Teslassian/E344/Reports/Assignment 1/App-B.tex

\chapter{GitHub Activity Heatmap}
\makeatletter\@mkboth{}{Appendix}\makeatother
\label{appen:github_heatmap}

     \begin{figure}[!htb]
     \centering
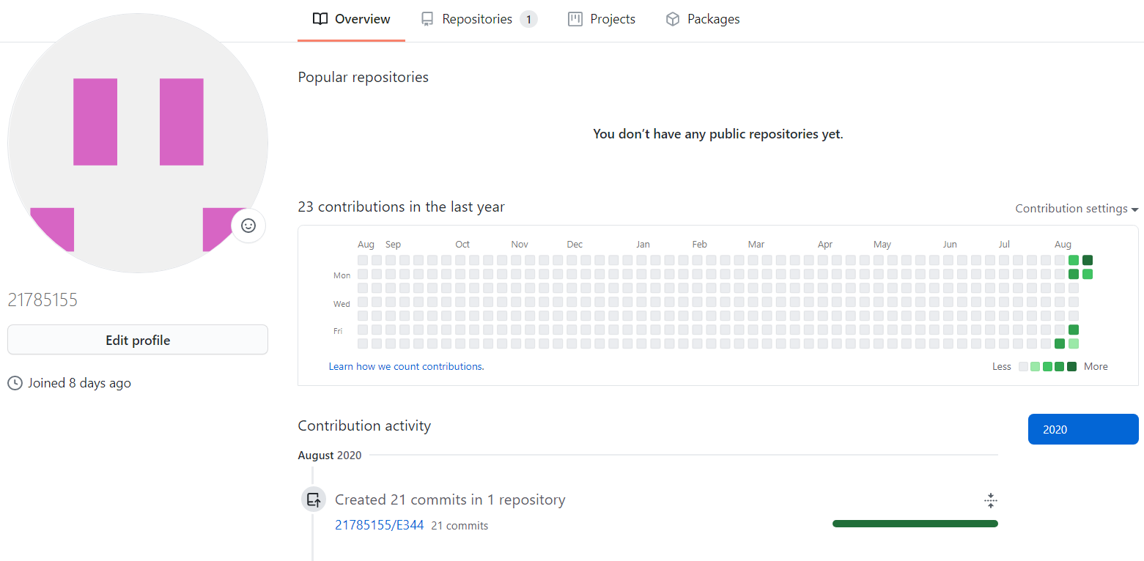
[picture p28: Reports/Assignment 1/Figures/heat.png]
     	\fbox{}
	\label{fig:github}
	\end{figure}
