Teslassian/E344/Reports/Assignment 3/von_Eschwege_21785155_A3.pdf

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

# E344 Assignment 3

## Daniel von Eschwege

21785155

Report submitted in partial fulfilment of the requirements of the module Design (E) 344 for the degree Baccalaureus in Engineering in the Department of Electrical

and Electronic Engineering at Stellenbosch University.

## October 25, 2020

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

## Plagiaatverklaring / Plagiarism Declaration

1. Plagiaat is die oorneem en gebruik van die idees, materiaal en ander intellektuele eiendom van ander persone asof dit jou eie werk is.
Plagiarism is the use of ideas, material and other intellectual property of another’s work and to present is as my own.
2. Ek erken dat die pleeg van plagiaat ’n strafbare oortreding is aangesien dit ’n vorm van diefstal is.
I agree that plagiarism is a punishable offence because it constitutes theft.
3. Ek verstaan ook dat direkte vertalings plagiaat is.
I also understand that direct translations are plagiarism.
4. Dienooreenkomstig is alle aanhalings en bydraes vanuit enige bron (ingesluit die internet) volledig verwys (erken). Ek erken dat die woordelikse aanhaal van teks sonder aanhalingstekens (selfs al word die bron volledig erken) plagiaat is.
Accordingly all quotations and contributions from any source whatsoever (including the internet) have been cited fully. I understand that the reproduction of text without quotation marks (even when the source is cited) is plagiarism
5. Ek verklaar dat die werk in hierdie skryfstuk vervat, behalwe waar anders aangedui, my eie oorspronklike werk is en dat ek dit nie vantevore in die geheel of gedeeltelik ingehandig het vir bepunting in hierdie module/werkstuk of ’n ander module/werkstuk nie.
I declare that the work contained in this assignment, except where otherwise stated, is my original work and that I have not previously (in its entirety or in part) submitted it for grading in this module/assignment or another module/assignment.
21785155 Studentenommer / Student number | Handtekening / Signature
D.H. von Eschwege Voorletters en van / Initials and surname | October 25, 2020 Datum / Date

i

# Contents

Declaration | i
List of Figures | iv
List of Tables | v
Nomenclature | vi
1. System design | 1
2. Voltage regulation | 3
3. Temperature sensor conditioning circuit | 6
4. Heart rate sensor | 10
5. Calibration and digitisation | 15

ii

6. System and conclusion | 17
Bibliography | 18
A. Social contract | 19
B. GitHub Activity Heatmap | 20
C. Stuff you want to include | 21

iii

# List of Figures

1.1. System Diagram | | 1
2.1. Linear Voltage Regulator | | 3
2.2. Switchmode Voltage Regulator | | 4
2.3. Switchmode Voltage Regulator Noise | | 4
2.4. Linear Voltage Regulator Output | | 5
2.5. Switchmode Voltage Regulator Output | | 5
3.1. Temperature Sensor Circuit | | 7
3.2. Simulated bode plot of filter | | 8
3.3. Complete Circuit Output | | 9
4.1. Complete Circuit | 10
4.2. Fast fourier transform of stimulus | 11
4.3. Frequency response of filters | 13
4.4. Filter input and output | 13
4.5. Signal Conditioning | 13
4.6. Full input versus output range | 13
4.8. Total current usage | 14
5.1. Voltage against temperature | 15
5.2. Flow chart for heart-rate digitisation | 16

iv

# List of Tables

2.1. Comparison of Voltage Regulators | | 4
3.1. Temperatures and Corresponding Voltage Levels | | 6

v

# Nomenclature

Variables and functions

fc | Cutoff frequency
VREF | Reference voltage
Av | Gain
β | Feedback fraction
VCM | Common-mode voltage
VID | Differential-mode voltage
η | Efficiency
ωn | Natural Frequency
tr | Rise time (90%)
Vref | Reference Voltage

vi

Acronyms and abbreviations

PWM | Pulse-width modulation
FFT | Fast Fourier transform
DC | Direct Current
Q-factor | Quality factor
BPM | Beats per minute
UTP | Upper trip point
LTP | Lower trip point
AC | Alternating Current
DC | Direct Current
ADC | Analog-to-Digital Converter

vii

# Chapter 1

# System design

## 1.1. System overview

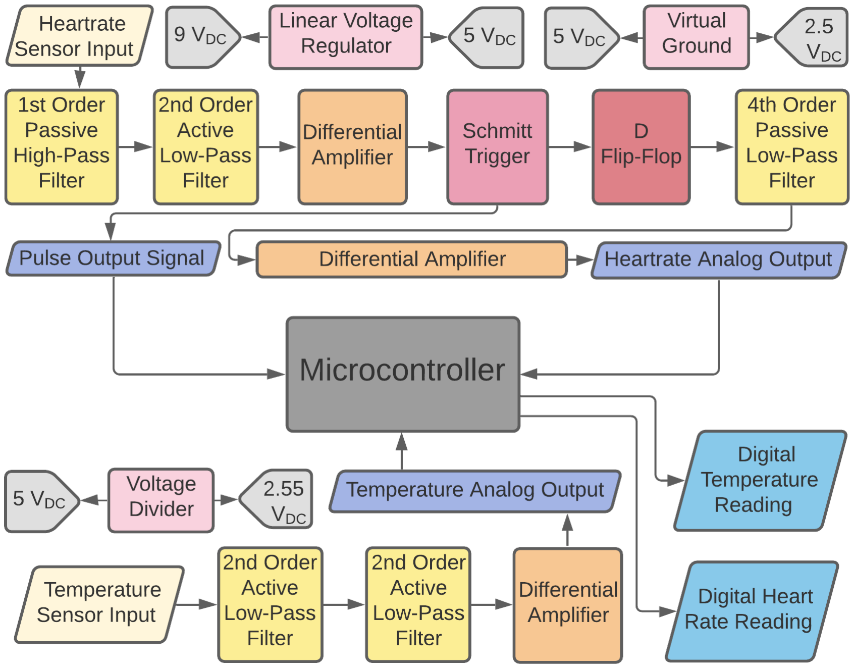
[picture p29: figure]

Figure 1.1: System Diagram

A health monitoring system is designed, consisting of a temperature sensor and an optic heart-rate monitor, interacting with a microcontroller. Figure 1.1 provides an overview. Since physical sensor measurements are ill-suited for digital interfacing, the main focus of this report is the conditioning, filtering and amplification of the aforementioned.

The temperature sensor input is subject to noise, has an unwanted DC offset and an amplitude of insufficient magnitude for AD-conversion. Two second-order low-pass filters were cascaded to clear the signal of noise. This may seem excessive at first, but the cascaded setup allows for the use of less costly components (see Section 3.2), as well as producing an output signal subject to very low noise (see Section 3.3), crucial with regards accuracy in Assignment

3. Following filtering, amplification is required. Since the filtered signal still contains a DC offset, and the differential amplifier requires a virtual ground, the voltage divider connects to the amplifier in such a way as to simultaneously remove the input DC offset and add the virtual ground. The signal is thus amplified to the degree required by a microcontroller ADC.

The heart-rate sensor input is to be converted to a pulse signal and an analogue output, corresponding to heart-beats and the heart-rate respectively. On account of the noise present in the sensor input, signal conditioning is required. Furthermore, the small amplitude of the sensor input necessitates amplification. A first order passive high-pass filter and a second order active low-pass filter attenuate both high- and low-frequency noise. Despite designing with maximal simplicity in mind to reduce cost and complexity, the filters still performing more than adequately. Thereafter, a differential amplifier produces a signal with a large amplitude and little noise. A Schmitt Trigger then outputs a pulse signal with a frequency corresponding to the heart-rate. The Schmitt Trigger was chosen as it provides a noise margin via hysteresis. An analogue voltage output is required for the microcontroller -filtering and peak detection using diodes was considered but discarded, as non-linear diodes result in extremely slow simulation. Rather, the pulse output signal was converted to a pulse-width modulated signal, where the frequency of the former determines the duty cycle of the latter. This was done as PWM signals lend themselves to conversion-to-analogue by simple filtering. The PWM signal was obtained by using a D Flip-Flop and a RC-circuit (see section 4.2). A fourth order passive RC filter is then used - passive components reduce cost,

current usage and simulation time. The filter is of high order as to minimize noise while meeting the settling time requirement. Finally, the signal is amplified to achieve the required range.

A microcontroller produces digital readings of the temperature and heart-rate by using the analogue output voltage (representative of the temperature measurement) and the pulse output signal (representing the the heart-rate) in a calibration formula programmed into the

microcontroller, where the former is linearly scaled and the latter is converted to a digital reading using the signal frequency. The frequency is detected by measuring the time-interval between rising edges.

A voltage regulator supplies power to all sub-circuits of which the system is comprised. Capable of a maximum current of 100 mA at 5 V, it is more than sufficient to supply the current drawn by Assignments 1, 2 and 3 - 12.8 mA, 13.0 mA and 50 mA respectively, where the current draw for Assignment 3 is estimated based on the typical current draw of a microcontroller of the type that would suffice for analogue-to-digital conversion of the heart-rate and temperature data [1]. All circuits were designed with conservative current use in mind as to increase

efficiency of the health-monitoring system.

# Chapter 2

# Voltage regulation

## 2.1. Introduction

Given a 9 VDC battery, a voltage regulator is required to reduce the voltage level to 5 VDC, as this is the level required by the operational amplifiers used in the rest of the circuit. Two voltage regulators were considered: the LM7805 linear regulator as well as the LM2595 switchmode regulator, which were both analysed with regards to efficiency and noise by means of calculations and simulations. According to the literature, the linear regulator produces insignificant levels of noise, but has low power efficiency of around 50% for input and output of 9 VDC and 5 VDC [2] respectively. The switchmode regulator can provide power efficiency of around 85%, but outputs a considerable amount of noise [3]. With the aforementioned in mind, both of the regulators were simulated (Section 2.2) to determine the best trade-off

between low noise and efficiency.

## 2.2. Design

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
LM7805

V1

9

9V | Regulated_Output

Figure 2.1: Linear Voltage Regulator

The LM7805 chip and its required peripheral circuit is shown in Figure 2.1. Component values were obtained from the datasheet [2]. For testing purposes, a 50 Ω

load was connected to the regulator, drawing 100 mA.

The LM2595 chip is shown in figure 2.2, built into the required peripheral circuit. Capacitor and inductor values were obtained from the datasheet [3]. Resistor values were calculated:

VOUT = VREF

1 +

R2
R1

!
where VREF = 1.23V

Selecting R1 as 1 kΩ, with Vout as 5 V gives R2 as 3065 Ω. For testing purposes, a 50 Ω load was connected to the regulator, drawing 100 mA.

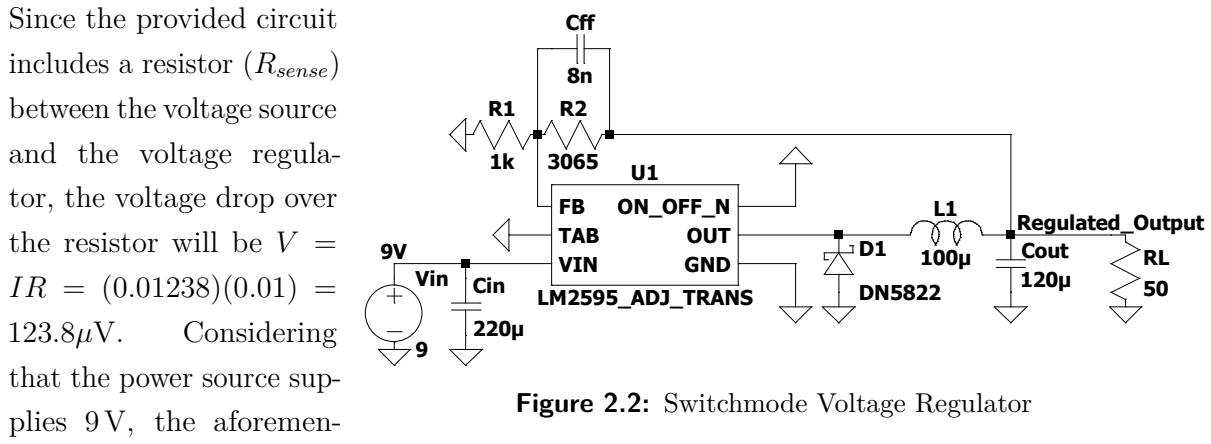
[picture p30: figure]
Cout; Cin; RL 50 Vin; Cff; FB TAB VIN; ON_OFF_N OUT GND; LM2595_ADJ_TRANS; Regulated_Output; Since the provided circuit; includes a resistor (Rsense); between the voltage source; and the voltage regula-; tor, the voltage drop over; the resistor will be V =; Considering; that the power source sup-; plies 9 V, the aforemen-

Figure 2.2: Switchmode Voltage Regulator

tioned voltage drop is negligible - it is not nearly enough to approach the dropout voltages of the voltage regulators, which are 6.7 V for the LM7805 and 5.8 V for the LM2595 in the case of a 5 V output.

## 2.3. Results

The input and output power measurements are displayed in table 2.1. Comparing the efficiency of the respective regulators, it is clear that the switchmode regulator is considerably more efficient. However, simulation results in a settling time of 1.24 ms, which is quite slow.

Table 2.1: Comparison of Voltage Regulators

| Iin [mA] | Iout [mA] | Pin [mW] | Pout [mW] | η [%]
LM7805 | 105.06 | 100.05 | 945.54 | 500.55 | 52.93
LM2595 | 57.54 | 99.65 | 517.86 | 496.6 | 95.89
Furthermore, | the
switchmode regulator
creates noise levels
of up to 950 µVpp in
the output, as can
be seen in figure 2.3,
whereas the linear regulator produces almost no noise (figure 2.4). Noise is a problem, as the

large gain of the differential amplifier will increase the noise levels, which will distort the output.


Figure 2.3: Switchmode Voltage Regulator Noise

The output graphs of the voltage regulators are shown in figures 2.4 and 2.5, and clearly demonstrate that both regulators produce the desired output current and voltage. The input current for the switchmode regulator is not shown as it obscures the graph, but it has an average value of 57.54 mA. All relevant values can be found in table 2.1.

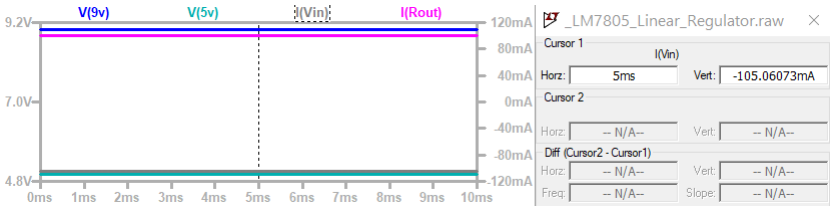
[picture p31: figure]

Figure 2.4: Linear Voltage Regulator Output

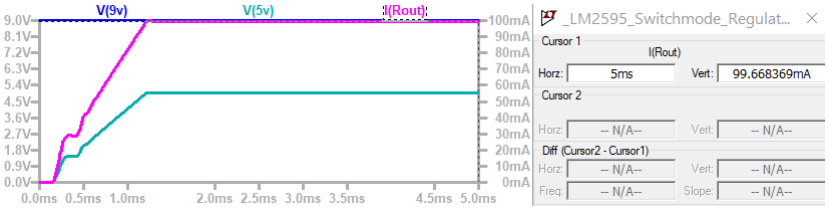
[picture p32: figure]

Figure 2.5: Switchmode Voltage Regulator Output

## 2.4. Summary

Concluding, it has been shown that both regulators behave as expected, but that the levels of noise present in the switchmode regulator make it unsuitable for the design at hand, as input signals, and thus the noise as well, will be amplified to levels of noise in the output signal that are unacceptable for an ADC input. The linear regulator will therefore be used. This choice was made despite the fact that the switchmode regulator is approximately 40% more

efficient than the linear regulator. However, since the total current drawn is still very low, efficiency is not of concern.

# Chapter 3

# Temperature sensor conditioning circuit

## 3.1. Intro

The temperature sensor signal presents as DC with 50 Hz AC noise superimposed. The sensor output amplitude is too small to act as ADC input and the desired range is only from 34◦C to 42◦C. The two aforementioned considerations necessitate amplification of the relevant part

of the temperature sensor signal to a 0 to 5 V range. Conditioning circuitry is thus required, namely a filter, an offset removing subcircuit, as well as an amplifier. The filter attenuates the AC noise, the offset subcircuit removes enough of the DC offset as to obtain an output signal centered around 2.5 V, ensuring the largest possible output swing. Finally, the amplifier increases the magnitude of the input signal in order to be suitable as input for an ADC.

## 3.2. Design

The amplifier was designed first, as its gain serves as the determining factor for the amount of noise reduction that is required from the filter. A TLC2272 op-amp was chosen as it allows for an output very close to its rails. Since the output signal has to be centered around 2.5 V, a differential amplifier was decided upon, allowing for adjustment of the negative input in order to determine the output offset. The zero-reference temperature sensor voltage (Vzero) is 440 mV, and increases by 35 mV for every 1◦C (V∆). Therefore Vtemp = Vzero + V∆ × T emp.

As shown in table 3.1, the maximum input voltage swing equals 1.91 − 1.63 = 0.28V, and

Table 3.1: Temperatures and Corresponding Voltage Levels

Temperature [◦C] | 32 | 38 | 42
Voltage [V] | 1.63 | 1.77 | 1.91

has a DC offset of 1.77 V. Amplification is needed to reach an output voltage swing of 5 V, which, combined with a 2.5 V
DC offset, ensures that the circuit uses the input range in accordance to specification, while excluding the lower and upper temperature ranges (i.e. below 34◦C and above 42◦C). Therefore:

Av =

Vout

Vin

=

5
0.28

= 17.86

Considering the current design requirement of 25 mA maximum, Rinput is selected as 10 kΩ, which will therefore, at the highest possible voltage level of 5 V, draw 0.5 mA. This gives Rfeedback = 178.6kΩ, according to Av =

Rfeedback
R

[4]. Rinput corresponds to R1 and R2, and

Rfeedback to R3 and R4 in the design diagram (figure 3.1), which is shown here already as to

aid with explanation of the design process. Rfeedback required adjustment to 230 kΩ upon simulation due to the non-linear Av curve characteristic of op-amps. However, Av = 17.86 is still used in calculations as that is the gain obtained after adjustment of Rfeedback.

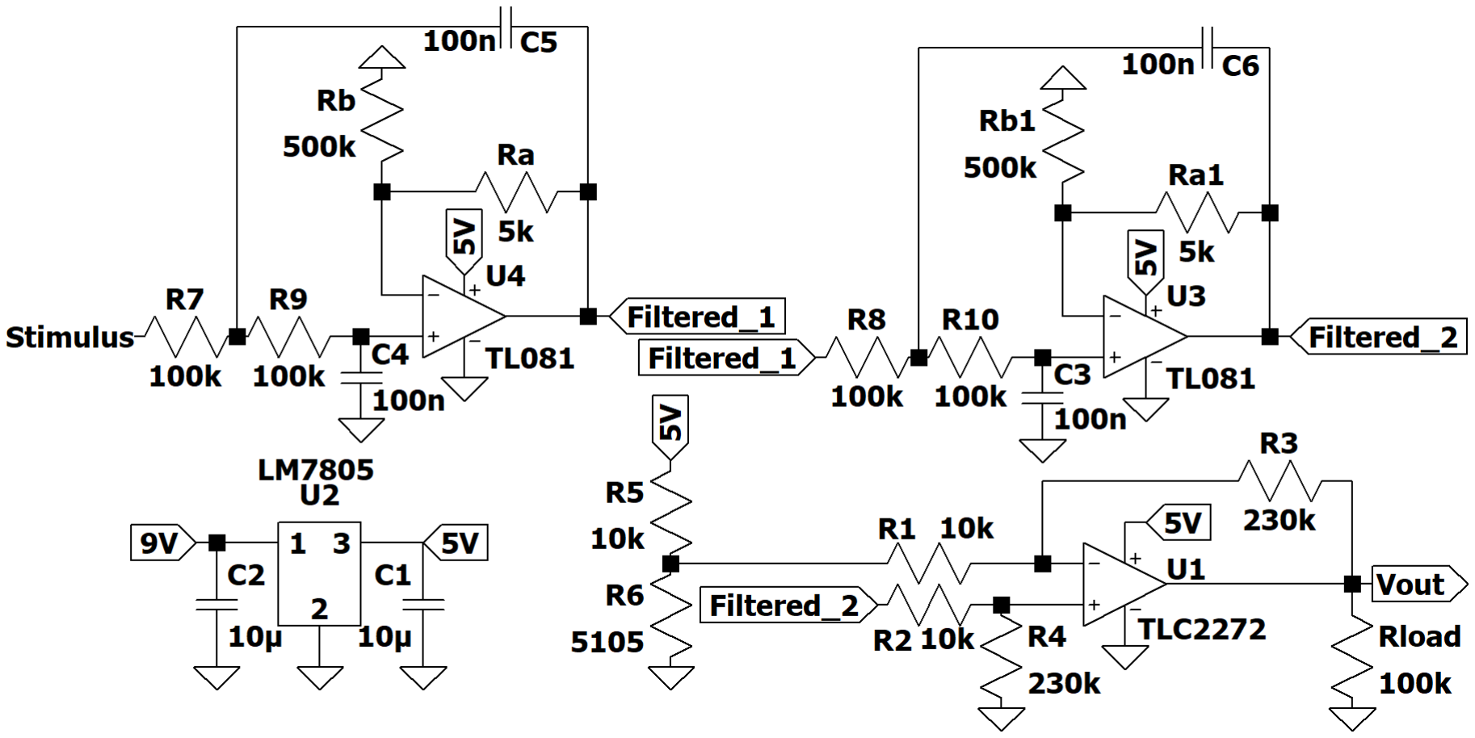
[picture p33: figure]

Figure 3.1: Temperature Sensor Circuit

Two points require consideration:

1. The DC offset of the input signal is undesired and has to be removed as to obtain a zero-mean input signal. This can be achieved by designing another sub-circuit using another op-amp, for example. This adds to the cost and complexity of the circuit.
2. The output signal has to be centered around 2.5 V. This means that a DC offset has to be added in the form of a virtual ground.

When considered in conjunction with each other, the DC offset alteration can be resolved in one step, thereby reducing cost and complexity significantly. The decision was therefore made to use a differential amplifier with the input signal connected to the positive input, after which the voltage required at the negative input can be calculated in such a way as to simultaneously subtract the offset and add the virtual ground in one step, thereby producing an output DC offset of 2.5 V. This approach also simplifies the design procedure, as it renders a separate virtual ground completely superfluous, thereby also removing the need to perform any virtual ground calculations per se. (Lecture Video 2, minute 11 [5] mentions this to be an acceptable approach). For a non-inverting amplifier, the calculation thus reduces to a simple differential amplifier gain formula [4]:

Vout =

Rfeedback
R

(Vin+ − Vin−) → 2.5 = 17.86 (1.77 − Vin−)

With Vout as 2.5 V, Vin+ as 1.77 V and the resistor values as calculated previously, Vin− = 1.63 V. The voltage at Vin− can be set by means of a voltage divider circuit, which takes 5 V as input and is calculated as follows (resistor names in formulae are selected to conform with Figure 3.1): Vin− = 5( R6
R6×R5

). Selecting R5 as 10 kΩ gives R6 = 4.84 kΩ.

Here, the common-mode voltage, VIC, needs consideration; the TLC2272 can operate with a common-mode voltage of VDD− to VDD+ − 1.5 [6]. Since Vin+max
is 1.91 V and Vin− is 1.63 V, the largest possible common mode voltage is VIC =

1.91+1.63
2 = 1.77 V, which is well below the maximum limit. Since Vin− stays constant, the lower limit will never be reached either.

Simulation was used to select a filter, and has shown the following: a passive low-pass filter is very simple, but produces too much noise and does not meet the settling time requirement. The active low-pass filter meets both the noise and settling time requirements, but requires the TLC2272 op-amp to do so. Since a single TLC2272 op-amp is more expensive than multiple TL081 op-amps, the decision was made to rather use cascaded second order low-pass filters, using the TL081. This is somewhat more complex, but lowers the cost, as the final circuit now only uses three op-amps, two of which are the cheaper TL081 models. Assignment 3 further motivates the decision for increased filter complexity, as the cascaded setup produces an output signal with extremely low noise, which is indispensable for meeting the bonus requirements during calibration and digitisation - see section 5.1.2. Following selection, the filter is designed:

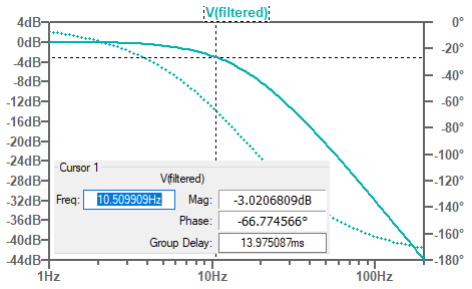
[picture p34: figure]

Figure 3.2: Simulated bode plot of filter

A filter gain of close to unity is desired; for RA =
500 kΩ, RA = 5 kΩ, according to the formula:
Av = 1 + RA
RB

[7]. The settling time requirement of

100 ms means that a cutoff frequency of more than 10 Hz is needed, while the attenuation of noise requires a cutoff frequency below 50 Hz. fc = 15 Hz was chosen - the bandwidth thus also is 15 Hz. Choosing R (R7 and R9 in the diagram) as 100 kΩ gives C (C4 and C5) as 106.1 nF, according

to fc =

1
2πRC . The given cutoff frequency implies a rise time of 19.1 ms according to tr ≈

1.8
wn

=

1.8
2π(15) [8]. This meets the requirement of 100 ms, even when cascaded. After design

completion, this filter is then duplicated and connected back-to-back in order to form cascaded second-order low-pass filters, as seen in figure 3.1. The simulated frequency response is shown in figure 3.2. While 10.5 Hz is somewhat lower than designed, it still falls within the range determined by the cutoff frequency and settling time requirements, as discussed previously. Assuming that each resistor is subjected to an average voltage of 2.5 V, while op-amps draws 3 mA [6], the calculated current consumption of the temperature sensor circuit is:

Itotal = (3) ².5

10k + (2) 2.5

230k + (4) 2.5

100k + (2) 2.5

500k + (3) ².5

5k + (2) 2.5
230k + (3)3mA = 11.38mA
This leaves 88.62 mA for the rest of the health-monitoring system.

## 3.3. Results

The designed circuit receives an input signal ranging from 1.67 to 1.94 V for Vin+, which is somewhat higher than the calculated values of 1.63 to 1.91 V, and is due to the filter adding some offset. This can easily be overcome by adjusting the voltage divider. Vin− receives 1.7 V. Both Vin− and Vin+ thus fall well within the allowable range for the TLC2272, which is from VDD− − 0.3 to VDD+ [6]. The circuit produces a signal centered at 2.5 V with an output swing of 4.86 V (figure 3.3a), exceeding the required 3.5 V. The absolute maximum amount of noise measured is 25.6 mV (figure 3.3c), and the settling time is 67 ms (figure 3.3d), thereby meeting the requirements of 50 mV and 100 ms respectively. Total current draw is 12.83 mA (figure 3.3b), well below the required 15 mA, and very close to the calculated 11.38 mA. The output signal (light blue) is shown in figure 3.3a.

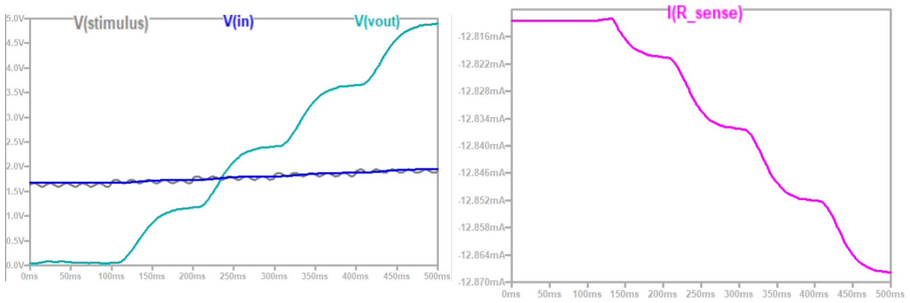
[picture p35: figure]

(a) Full Input and Output Range | (b) Current of Entire System

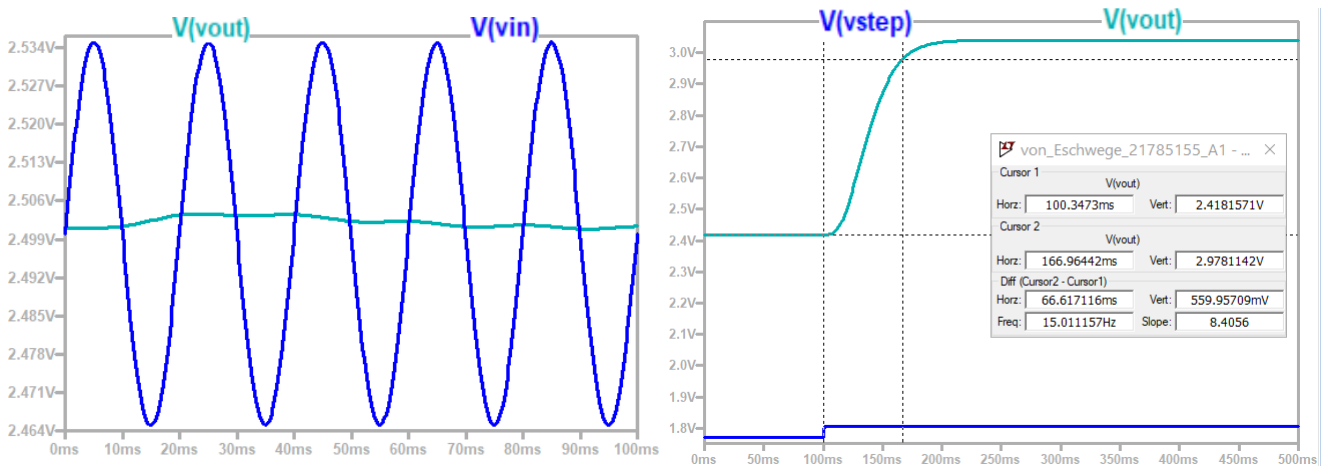
[picture p36: figure]

(c) Simulated Noise Suppresion | (d) Simulated Output Rise Time

Figure 3.3: Complete Circuit Output (a) Output Range: 0.1 to 4.85V. Input Range: 1.63 to 1.94 V. (b) Current draw below requirement. (c) Noise suppressed to negligible levels. (d) Settling time within 100 ms.

## 3.4. Summary

Concluding, the circuit performs very well and successfully amplifies the temperature sensor output to a level that is readable by the microcontroller ADC, all the while attenuating almost all noise present in the input. The design is somewhat more complex, which however is justified by the requirements of Assignment 3. While being complex, it still is inexpensive, as it uses less of the TLC2272 op-amps. The design meets all base and bonus requirements requirements with a good margin to spare, all the while using only three op-amps, two of which are the cheaper TL081 models.

# Chapter 4

# Heart rate sensor

## 4.1. Introduction

Circuits pertaining to signal conditioning, pulse signal and analogue output generation will be discussed. Conditioning is done via filtering and amplification, thereafter thresholding and pulse-width modulation is used to generate outputs. Active filters provide high input and low output impedance, and a large Q-factor [9]. A differential amplifier is suitable for amplification, as the gain is referenced against a customizable voltage [4]. A Schmitt Trigger is well-suited for pulse generation, as it provides a noise margin [10]. PWM signals can be converted to analogue using filtering [11].

## 4.2. Design

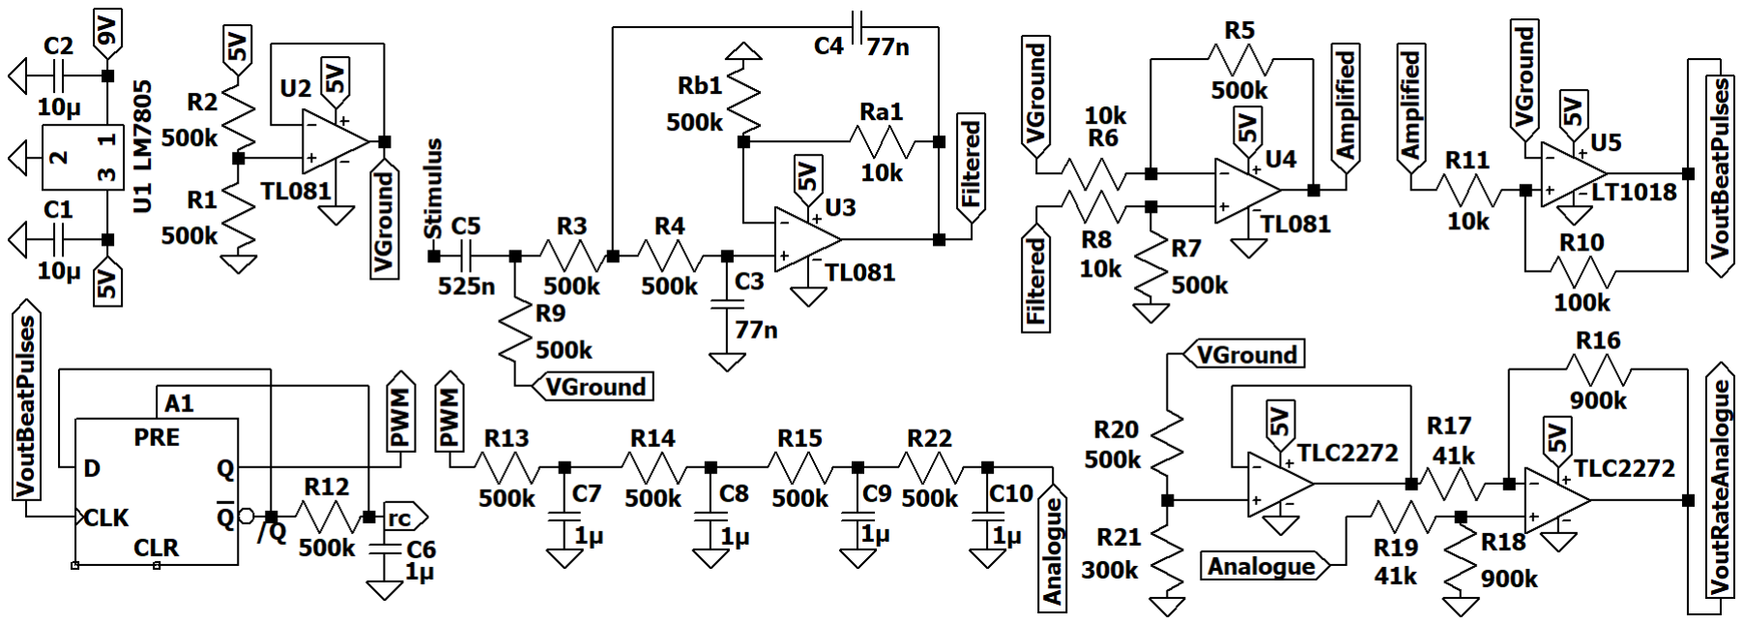
[picture p37: figure]

Figure 4.1: Complete Circuit

### 4.2.1. Signal Conditioning

The complete circuit is shown upfront in figure 4.1 to aid explanation. The largest resistor in sub-circuits is always chosen to be 500 kΩ as to reduce current usage. The TLC2272
op-amp has VCM of −0.3 to 4 V, VID = ±16 V , Vinmax | = VDD+ and Vinmin | = VDD− −
0.3 [6]. The TL081 has VCM of 1 to 4 V, VID = ±30 V , Vinmax | = 3.5 V and Vinmin | =
1.5 V [12]. This information is given here as to avoid repetition - refer here when op-amp

characteristics are discussed. The design process now follows. The FFT of the stimulus input in figure 4.2 shows information residing between 0.8 to 2.5 Hz, corresponding to 50 and 150 BPM respectively. The other peaks represent noise at 0.25 Hz, as well as at twice and three times the message signal, and higher. Noise distorts square wave output, necessitating filtering. A first order passive high-pass filter, fc = 0.606 Hz, attenuates the low-frequency noise at 0.25 Hz. R18 = 500 kΩ, thus C8 = 525 nF according to fc =

1
2πRC .


Figure 4.2: Fast fourier transform of stimulus

A virtual ground centres the signal around 2.5 V, ensuring that the LPF input falls within the common-mode range of the TL081, which is used as it inexpensive [13]. A second

order active low-pass filter, fc = 4.1 Hz, filters out high frequency noise. R5 = R6 = 500 kΩ, C1 = C2 = 77 nF - see aforementioned formula. Cutoff frequencies were selected to
remove noise maximally while minimally affecting heart-rate data. The signal should reside slightly above 2.5 V to facilitate amplification (to be discussed) and to ensure common-mode input range compliance in the next stage. Thus, Rb1 = 500 kΩ and Ra1 = 10 kΩ since Av = 1 + RA
RB

[7]. A filter output with DC offset slightly

above 2.5 V allows for the use of a differential amplifier with the existing virtual ground connected to the negative input, removing the need for additional circuitry otherwise required. The signal is amplified according to VOUT =

Ra
Rb

(V2 − V1) [4], where Ra corresponds to R7 and

R9 and Rb to R8 and R10. The gain of 50 was selected to again provide a DC offset of 2.5 V, as it facilitates implementation of the comparator (to be discussed). Since the amplified signal

has an amplitude of only 1.66 V, the inexpensive TL081 was chosen despite having a smaller output range. Next, the signal is fed into a Schmitt Trigger - the LT1018 comparator allows for output very close to 0 and 5V and has a high gain. 5 V is produced if the input exceeds the upper trip point (UTP) and 0 V if the input falls below the lower trip point (LTP) [10]. The hysteresis width (wh = UTP - LTP) serves as a noise margin around the reference voltage, VREF [10]. The DC offset of 2.5 V of the amplified signal requires VREF = 2.5 V, once again

allowing for the use of the existing virtual ground. Pulse duration is designed for the highest frequency, as it will then also meet the requirement for lower frequencies. Since 150 BPM corresponds to a period of 0.4 s, wh is selected to ensure an output pulse width of at least 150 ms; 200 ms selected to account for noise. The amplified signal approximates a sinusoid:
y1 = 1.66 sin(2π(2.5)t1) + 2.5 | (4.1) | y2 = 1.66 sin(2π(2.5)t2) + 2.5 | (4.2)

Subtracting 4.2 from 4.1 yields y1 − y2 = wh = 0.52 V for t1 =0.01 s and t2 = 0.21 s, resulting

in a theoretical pulse width ranging from 0.2 to 0.625 ms, which is sufficient. wh also is an order of magnitude larger than the highest input signal noise levels, increasing design fidelity. Now, UTP = 2.75 V, LTP = 2.25 V, UTP = VREF + βV cc and LTP = VREF − βV cc, thus β = 0.05 [10]. Further, β =

R22
R22+R21

. Thus R21 = 190 kΩ and R22 = 10 kΩ. (R21 was adjusted to 100 kΩ to account for loading effects). A one-shot was considered to extend the pulses, but

was omitted as it was superfluous. The pulse output frequency thus represents the heart-rate.

### 4.2.2. Analogue Transducer

Obtaining an output suitable for a microcontroller presents itself as a problem of converting frequency to analogue. The decision was made to obtain a PWM signal from the FM pulse signal, as PWM signals readily lend themselves to conversion-to-analogue using a simple low-pass RC filter. Pulse-width modulation was achieved by means of a D flip-flop. The essence of the design is to continually keep the output high at first, but to then drive the output low for a fixed time, once per period. Since the period of the clock signal varies against BPM, driving low for a fixed amount of time results in a different ratio of the pulse being low at different frequencies, producing a varying duty cycle. Specifically, the previously generated pulse signal is used as a clock signal for the D flip-flop, and the not-Q output is fed back into the data line. This would normally drive the output high for all time t; thus a RC circuit is added of which the capacitor is charged by the not-Q output, and connected to the SET-line of the flip-flop. Once the capacitor charges to 2.5 V, Q is pulled high and not-Q low until the next rising edge of the clock input inverts Q and not-Q. The result is a slightly delayed PWM signal, with a large duty cycle at high frequencies, and vice-versa. The PWM output is consistent as long as the capacitor charge time is selected to be shorter than the narrowest pulse of the clock signal. See section 4.3, figure 4.7a for output. For the RC circuit, R1 = 500 kΩ gives C = 1µ, according to the capacitor charge/discharge exponential equations - the extended solution (via Matlab scripting) is given in Appendix C

for the sake of brevity. Having obtained a PWM signal, a fourth order passive low-pass filter produces analogue values in the range of 0.95 to 1.2 V. A cutoff frequency of 0.3 Hz ensures maximal attenuation of noise while maintaining a 5% settling time of 10 seconds. Therefore

R = 500 kΩ and C = 1 µ. Finally, the analogue output is amplified by means of a TLC2272 differential amplifier with a negative input at 0.938 V. A gain of 20 produces a sufficient output range. Resistor values were increased as to minimize loading effects - thus R2 = R12 = 900 kΩ and R11 = R13 = 45 kΩ according to VOUT =

Ra
Rb

(V2 − V1) [4]. Loading effects still had a slight effect, and required adapting R11 and R13 to 41 kΩ. An analogue transducer is thus designed. For microcontroller integration, a log-linear scale can linearise the analogue output, and the calibration constant is calculated. The slope is 0.8−2.5
4.7−0.5 = −0.404. Thus, for 150 BPM, f = 2.5 = −0.404V + C = −0.404(0.5) + C → C = 2.702.

Total current is calculated using 1.4 mA per TL081 [12], 2.2 mA per TLC2272 [6] and 110 µA per LT1018 [14]. Non-trivial resistors are all approximated using 5 V over, as to err on the side of caution: 4(1.4m) + (2.2m) + (110n) + 16
5
500k

+ 3
| 5 10k

| + 2
| 5 41k
| +
5
100k
= 9.75 mA.

## 4.3. Results

The frequency response of the high- and low-pass filters gives −3dB at 0.61 Hz and −6dB at

4.3 Hz respectively - see figures 4.3a and 4.3b. This reflects design calculations near perfectly. Comparison of filter input and output in figure 4.4 shows a drastic noise reduction.

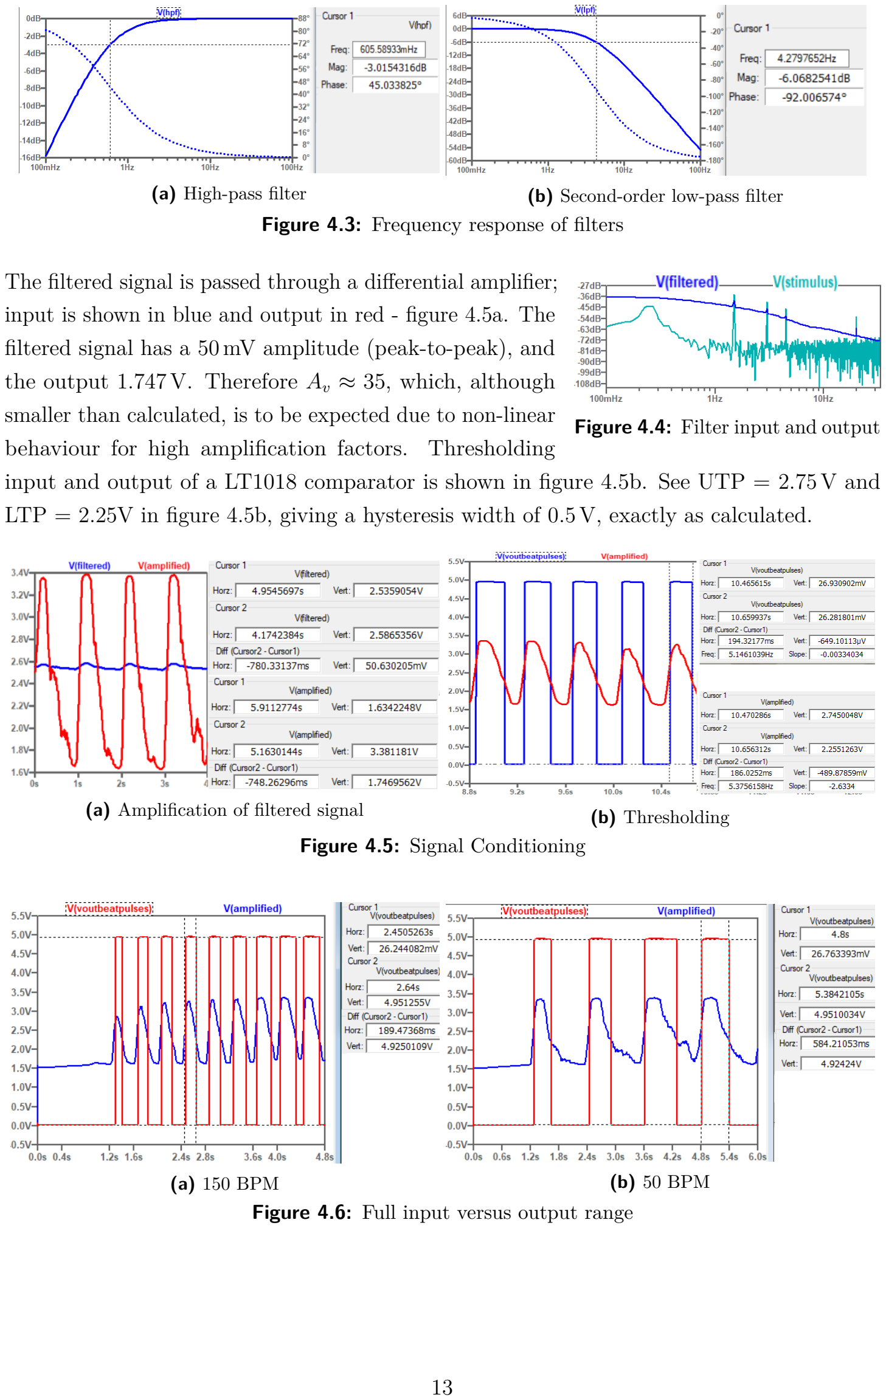
[picture p38: page 21]

(a) High-pass filter | (b) Second-order low-pass filter

Figure 4.3: Frequency response of filters

Figure 4.4: Filter input and output

The filtered signal is passed through a differential amplifier; input is shown in blue and output in red - figure 4.5a. The filtered signal has a 50 mV amplitude (peak-to-peak), and the output 1.747 V. Therefore Av ≈ 35, which, although

smaller than calculated, is to be expected due to non-linear
behaviour for high amplification factors. Thresholding
input and output of a LT1018 comparator is shown in figure 4.5b. See UTP = 2.75 V and LTP = 2.25V in figure 4.5b, giving a hysteresis width of 0.5 V, exactly as calculated.
(a) Amplification of filtered signal | (b) Thresholding

Figure 4.5: Signal Conditioning

(a) 150 BPM | (b) 50 BPM
Figure 4.6: Full input versus output range

The output ranges from 0.026 to 4.95V, with a pulse duration in range 189 to 584 ms in figures 4.6a and 4.6b, meeting the 150 ms requirement. The design remains consistent for specification deviations of ±10% amplitude and a DC offset variation of ± 0.2 V, as the

high-pass filter removes the DC component and the filter has a cutoff frequency low enough to greatly attenuate noise.

For the analogue transducer, a PWM signal is obtained. Section 4.2 explains the interrelation, where voutbeatpulses, pwm and rc in figure 4.7a correspond to the clock signal, Q, and the charging capacitor voltage respectively. The 5% settling time is 9.45 s. The duty cycle is 73% at 60 BPM and decreases to 56% at 150 BPM. Finally, amplification and filtering of the PWM signal produces analogue output, range 4.2 V (4.7b).

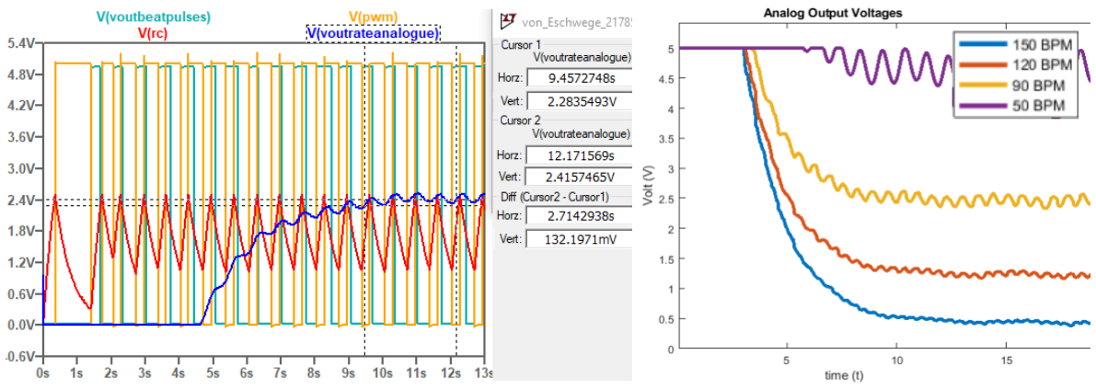
[picture p39: figure]

(a) PWM and settling time | (b) Analogue voltage output

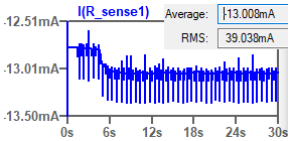
[picture p40: figure]

Figure 4.8: Total current usage

Total current draw is measured through Rsense, averaging 13.0 mA, meeting the bonus requirement of 15 mA - see figure 4.8. Considered in conjunction with Assignment 1, the combined current of 25.8 mA still is far less than the maximum current rating of 100 mA for the voltage regulator
- see section 2.2.

## 4.4. Summary

The design performs as expected, meeting all the requirements. Output pulse width is broader than required, analogue output is generated with discrete, non-overlapping values exceeding the required range, while settling to a final value according to specification. Current draw remains sub-15 mA. Upon implementation of the microcontroller, be cognizant of the fact that analogue output values scale in a slightly non-linear fashion. This is not a problem, and can easily be accounted for in software. By design, the system is limited to the 50 to 150 BPM range, but could be expanded using the existing design as a proof-of-concept.

# Chapter 5

# Calibration and digitisation

## 5.1. Temperature sensor

### 5.1.1. Analytical Design

Equation 5.1 for the sensor voltage and 5.2 for the amplifier, where the addition of a virtual ground and offset correction are combined by Vof fset.

Vsense = V0 + α(T) → T =

1
α
(Vsense − V0) | (5.1)

Vout = Av (Vsensor − Vof fset) → Vsensor =

Vout
Av
+ Vof fset | (5.2)

Combining 5.1 and 5.2 gives

T =

Vout
αAv

+

Vof fset − V0
α
= 1.6(Vout) + 34 | (5.3)

for V0 = 440 mV, α = 35 mV, Vof fset = 1.63 V, Av = 17.86. For an ADC:

ADC = (2¹⁰ − 1) Vin

Vref

→ Vin =

ADC(Vref )
2 10 − 1 | (5.4)

5.4 into 5.3, with Vout as ADC input, converts the sampled ADC value to temperature output:

T = (1.6)ADC(Vref )
2

10 − 1

+ 34 | (5.5)

### 5.1.2. Empirical Design

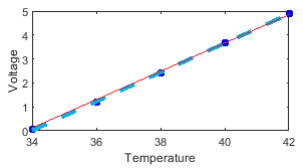
[picture p41: figure]

Figure 5.1: Voltage against temperature

Simulation yields the data points in figure
5.1. Linear regression results the empirical equation 5.6, graphed in light blue, which is implemented in software as to provide a digital temperature reading - see pseudocode below. Equation 5.5 corresponds closely to the analytical equation 5.3, graphed in red.

T = 1.644985924

Voutavg
+ 33.92887739 | (5.6)

Pseudocode:

V avg = V out / length(V out)
T = 1.644985924*V avg + 33.92887739

Python implementation yields a 1◦C temperature reading accuracy for the full input range,

which can, in part, be ascribed to the performance of the filters in section 3.2, which provide a signal almost completely devoid of noise. The accuracy requirement is met in less than 2 seconds, according to specification.

## 5.2. Heart rate sensor

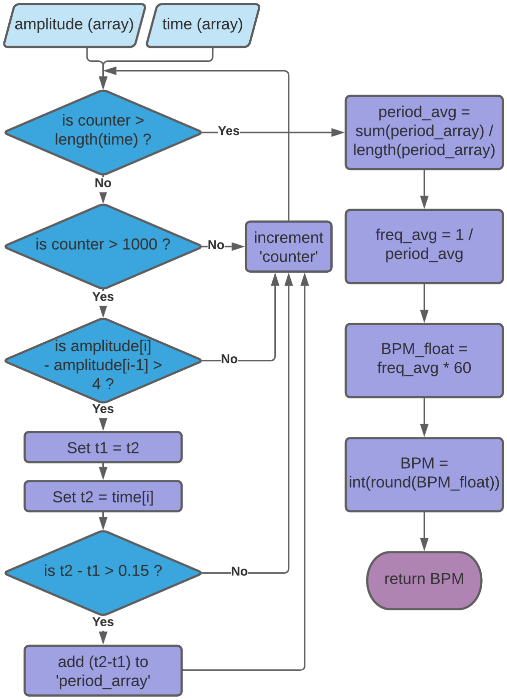
[picture p42: figure]

Figure 5.2: Flow chart for heart-rate digitisation

The heart-rate signal consists of square wave pulses of which the period correspond to the heart-rate (in BPM) ac-

cording to t =

60
BPM . For circuit output
data in the form of an signal amplitude and a time array, the approach is to set the difference between rising pulse edges as the period, averaged over 6 seconds of simulated time for increased accuracy. The frequency is then obtained from the period. Analytically, the frequency ranges from 0.83 to 2.5 Hz for heart-rates from 50 to 150 BPM. The heart-rate can thus be obtained by simply inverting the measured period and multiplying by 60: BPM =

60
t

. A flowchart of the algorithm is provided in figure 5.2. Empirical design was unnecessary as analytic design yielded accuracy up to 1 BPM upon implementation in Python. The accuracy requirement was met in less than 6 seconds, according to specification.

# Chapter 6

# System and conclusion

## 6.1. System

The complete design goes to show that a health-monitoring system, consisting of temperature and heart-rate sensing circuitry, powered by a voltage regulator and interfacing with a microcontroller, successfully performs its function while adhering to all base and bonus specifications. The modular design of different parts of the health-monitoring system simplifies both design and debugging.

The temperature sensor produces the desired output with full range. The filters ensure extremely low noise levels, allowing the ADC to distinguish the temperature to a very high degree of accuracy. The system uses more of the less costly components and is very power efficient.

The heart-rate sensor effectively converted a noisy input signal to a square wave output and an analogue output. Due to the second order low-pass filter, the heart-rate sensor is remarkably robust with respect to variations in noise, attenuating noise levels to below 6% of the signal

amplitude before creating a pulse output. The design also performs well on a variety of the normalised input data sets. Noise is filtered to the extent that it has a negligible effect on the digitalized reading. The system utilizes less costly components where possible and is very power efficient. Interfacing of real-world measurements with digital systems is achieved by connecting the heart-rate circuit to a microcontroller, producing a digital heart-rate reading.

## 6.2. Lessons learnt

1. LTSpice is a blessing, but can be an absolute nightmare with simulations. I’ve created a rough metric; it goes to show that 30% of my time was spent on circuit design, 10% on report writing, and 60% on debugging LTSpice simulation problems.
2. I believe to have greatly improved with regards to modularising and debugging not only circuits, but systems in general. Treating everything as a small problem to be solved furthered my conceptual understanding of component interaction.
3. I shouldn’t have gone surfing for the entirety of the first week of both terms. I lost a bunch of marks for saying this in Assignment 1, but the adage still holds true, so I’ll say it again.

# Bibliography

[1] “Arduino uno,” Farnell, 2018. [Online]. Available: https://www.farnell.com/datasheets/

1682209.pdf (https://www.farnell.com/datasheets/1682209.pdf)

[2] LM78LXXA 3-Terminal 0.1 A Positive Voltage Regulator, LM7805 Datasheet, Fairchild

Semiconductor Corporation, 2013.

[3] LM2595 SIMPLE SWITCHER® Power Converter 150-kHz 1-A Step-Down Voltage Regulator, LM2595 Datasheet, Texas Instruments, May 2016.
[4] W. Storr, “Operational amplifiers,” 2018. [Online]. Available: https://www.electronics-tutorials.ws/opamp
[5] M. J. Booysen, “E344 - lecture 2,” 2020. [Online]. Available: https://www.youtube.com/watch?v=5bzHyeFQCPo&feature=youtu.be (https://www.youtube.com/watch?v=5bzHyeFQCPo&feature=youtu.be)
[6] TLC227x: Advanced LinCMOS Rail-to-Rail Operational Amplifiers, TL2272 Datasheet,

Texas Instruments, 2016.

[7] W. Storr, “Filters,” 2018. [Online]. Available: https://www.electronics-tutorials.ws/filter
[8] H. Jordaan, “Control systems - 314,” 2020. [Online]. Available: https://learn.sun.ac.za/course/view.php?id=53481 (https://learn.sun.ac.za/course/view.php?id=53481)
[9] “Difference between active and passive filter.” [Online]. Available: https://circuitglobe.com/difference-between-active-and-passive-filter.html#ComparisonChart (https://circuitglobe.com/difference-between-active-and-passive-filter.html#ComparisonChart)
[10] W. Storr, | “Op-amp comparator,” | 2018. [Online]. Available: | https://www.
electronics-tutorials.ws/opamp/op-amp-comparator.html
[11] “Analog output - convert pwm to voltage.” [Online]. Available: https://www.instructables.com/id/Analog-Output-Convert-PWM-to-Voltage/ (https://www.instructables.com/id/Analog-Output-Convert-PWM-to-Voltage/)
[12] TL08xx: JFET-Input Operational Amplifiers, TL081 Datasheet, Texas Instruments, May

2015.

[13] “Octopart,” Octopart, 2020. [Online]. Available: https://octopart.com/
[14] LT1018 Micropower Dual Comparator, LT1018 Datasheet, Linear Technology.

# Appendix A

# Social contract

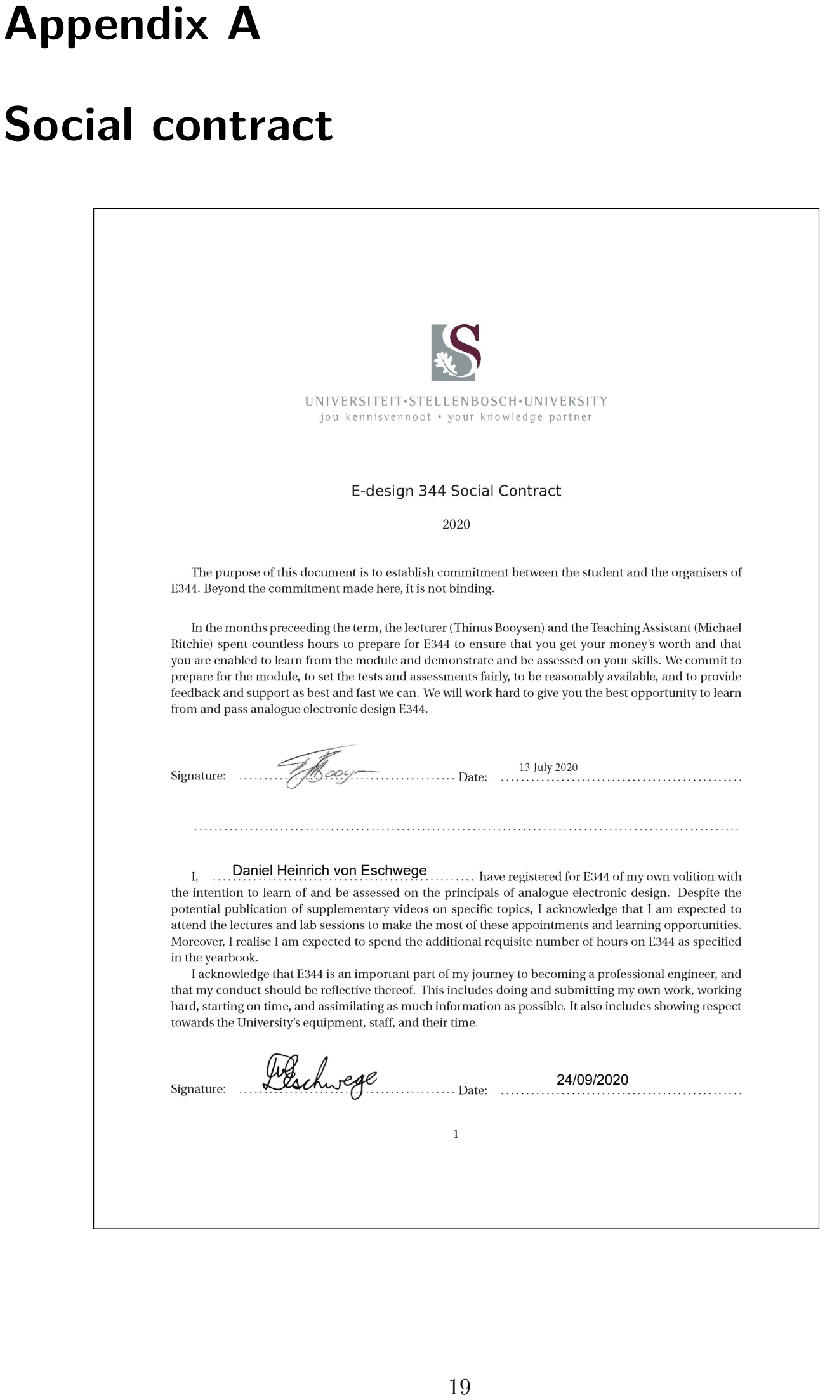
[picture p43: page 27]

24/09/2020

Daniel Heinrich von Eschwege

# Appendix B

# GitHub Activity Heatmap

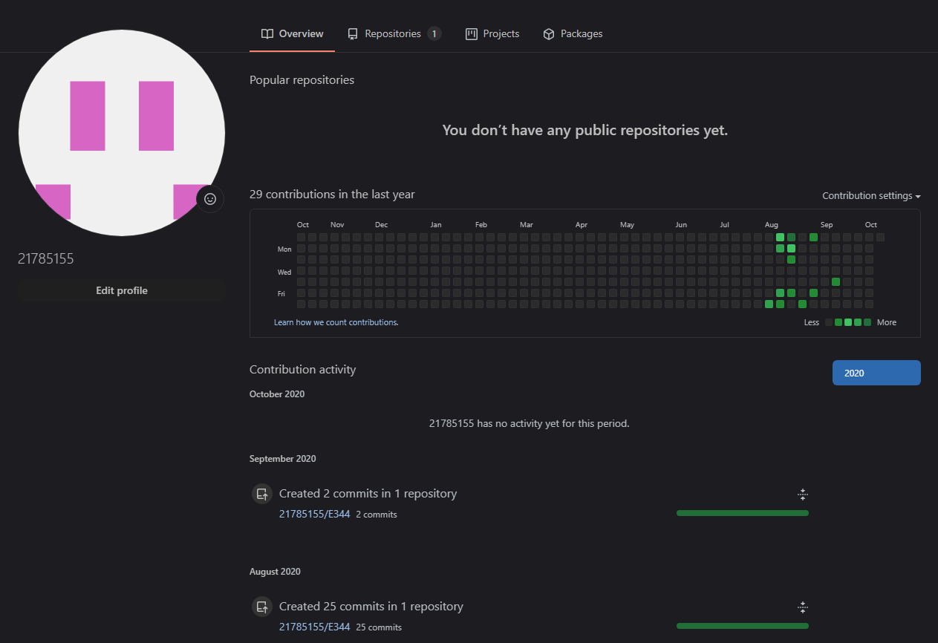
[picture p44: figure]

# Appendix C

# Stuff you want to include

### C.0.1. Calculation of transducer RC circuit

R1 = 500 kΩ. τ = RC. The capacitor charge oscillates between VL and VH. VH = 2.5 V. VL is reached for the first time at tL1 and VH at tH1
. VL is then reached at tL2

. For 150 BPM
(or 2.5 Hz), the pulse drives high for 0.2 ms. Since the capacitor has to charge faster than 0.2 ms, a charge time of 0.16 ms was selected to add a 20% margin, accounting for noise. Thus tH1 − tL1 = 0.16 and tL2 − tH1 = 0.4 − 0.16 = 0.24 for the 150 BPM signal. Finally,

VL = 5
1 − e

tL1
τ

VH = 5
1 − e

−tH1

τ

VL = VH

e

tL1
τ

giving C = 1µ, when solving using the following MatLab script:
