Teslassian/E344/Reports/Ass3Template/e344_A3_report.pdf

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

# E344 Assignment 3

## Egor Stewdent

00024601

Report submitted in partial fulfilment of the requirements of the module Design (E) 344 for the degree Baccalaureus in Engineering in the Department of Electrical

and Electronic Engineering at Stellenbosch University.

## October 22, 2020

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

## Plagiaatverklaring / Plagiarism Declaration

1. Plagiaat is die oorneem en gebruik van die idees, materiaal en ander intellektuele eiendom van ander persone asof dit jou eie werk is.
Plagiarism is the use of ideas, material and other intellectual property of another’s work and to present is as my own.
2. Ek erken dat die pleeg van plagiaat ’n strafbare oortreding is aangesien dit ’n vorm van diefstal is.
I agree that plagiarism is a punishable offence because it constitutes theft.
3. Ek verstaan ook dat direkte vertalings plagiaat is.
I also understand that direct translations are plagiarism.
4. Dienooreenkomstig is alle aanhalings en bydraes vanuit enige bron (ingesluit die internet) volledig verwys (erken). Ek erken dat die woordelikse aanhaal van teks sonder aanhalingstekens (selfs al word die bron volledig erken) plagiaat is.
Accordingly all quotations and contributions from any source whatsoever (including the internet) have been cited fully. I understand that the reproduction of text without quotation marks (even when the source is cited) is plagiarism
5. Ek verklaar dat die werk in hierdie skryfstuk vervat, behalwe waar anders aangedui, my eie oorspronklike werk is en dat ek dit nie vantevore in die geheel of gedeeltelik ingehandig het vir bepunting in hierdie module/werkstuk of ’n ander module/werkstuk nie.

I declare that the work contained in this assignment, except where otherwise stated, is my original work and that I have not previously (in its entirety or in part) submitted it for grading in this module/assignment or another module/assignment.

00024601 Studentenommer / Student number | Handtekening / Signature
E. Stewdent Voorletters en van / Initials and surname | October 22, 2020 Datum / Date

i

# Contents

Declaration | i
List of Figures | iv
List of Tables | v
Nomenclature | vi
1. System design | 1
2. Voltage regulation | 2
3. Temperature sensor conditioning circuit | 3
4. Heart rate sensor | 4
5. Calibration and digitisation | 5
Bibliography | 6
A. Social contract | 7

ii

B. GitHub Activity Heatmap | 8
C. Stuff you want to include | 9

iii

# List of Figures

1.1. System diagram | 1

iv

# List of Tables

v

# Nomenclature

update these

Variables and functions

p(x) | Probability density function with respect to variable x.
P(A) | Probability of event A occurring.
ε | The Bayes error.
εu | The Bhattacharyya bound.
B | The Bhattacharyya distance.
s | An HMM state. A subscript is used to refer to a particular state, e.g. si refers to the i th state of an HMM.

S A set of HMM states.

F A set of frames.

of | Observation (feature) vector associated with frame f.
γs(of ) | A posteriori probability of the observation vector of being generated by HMM state s.
µ | Statistical mean vector.
Σ | Statistical covariance matrix.
L(S) | Log likelihood of the set of HMM states S generating the training set observation vectors assigned to the states in that set.
N (x|µ, Σ) | Multivariate Gaussian PDF with mean µ and covariance matrix Σ.
aij | The probability of a transition from HMM state si to state sj .
N | Total number of frames or number of tokens, depending on the context.
D | Number of deletion errors.
I | Number of insertion errors.
S | Number of substitution errors.

vi

Acronyms and abbreviations

update this
AE | Afrikaans English
AID | accent identification
ASR | automatic speech recognition
AST | African Speech Technology
CE | Cape Flats English
DCD | dialect-context-dependent
DNN | deep neural network
G2P | grapheme-to-phoneme
GMM | Gaussian mixture model
HMM | hidden Markov model
HTK | Hidden Markov Model Toolkit
IE | Indian South African English
IPA | International Phonetic Alphabet
LM | language model
LMS | language model scaling factor
MFCC | Mel-frequency cepstral coefficient
MLLR | maximum likelihood linear regression
OOV | out-of-vocabulary
PD | pronunciation dictionary
PDF | probability density function
SAE | South African English
SAMPA | Speech Assessment Methods Phonetic Alphabet

vii

# Chapter 1

# System design

## 1.1. System overview

Here you insert a block diagram of your voltage regulation and signal conditioning system, including the temperature sensor and heart beat subsystems. Try to explain what configiation you chose and why. There is no need to specify the capacitor and resistor values here, but you want to capture the higher-level functional arrangement you have opted for. The diagram ties together the other chapters in this and the previous report and helps the reader understand how you have connected the different funtional blocks together to produce the outputs. For example, a block could be “Differential amplifier” or “level shifting op-amp” or “Low-pass filter” or “Linear regulator” and the like. Please use a drawing application, such as draw.io, MS Visio, or Power Point and export it as a PDF, so it looks good. If you feel brave, draw them in LATEXusing Inkscape/TikZ. Fig. 1.1 is a bad example that is completely irrelevant and just holds space for your beautiful system diagram [1]. Remember to state what your power budget is, basedn Assignment 1 and 2’s results.

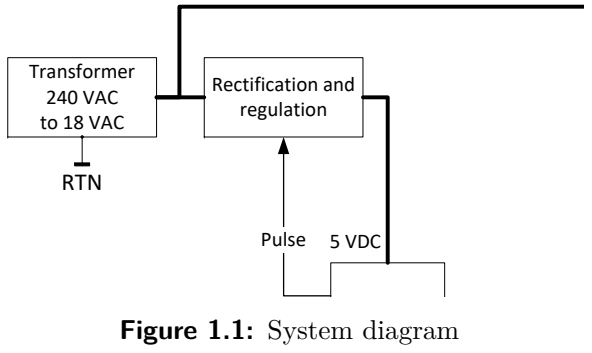
[picture p45: figure]
Rectification and regulation; Transformer 240 VAC to 18 VAC; Pulse; 5 VDC; RTN; Figure 1.1: System diagram

18 VAC

# Chapter 2

# Voltage regulation

## 2.1. Introduction

## 2.2. Design

NB: do not confuse empirical design (trial and error) with proper design.

## 2.3. Results

## 2.4. Summary

# Chapter 3

# Temperature sensor conditioning circuit

## 3.1. Intro

## 3.2. Design

## 3.3. Results

## 3.4. Summary

# Chapter 4

# Heart rate sensor

## 4.1. Introduction

## 4.2. Design

## 4.3. Results

## 4.4. Summary

# Chapter 5

# Calibration and digitisation

## 5.1. Temperature sensor

Include flow diagram of code or pseudocode as a list.

### 5.1.1. Analytical Design

Analytical expectations (calculations of what you expected the calibration to be) Please include a 10-bit make-believe ADC in your calculations

### 5.1.2. Empirical Design

Based on measurements, calculate calibration (to adapt or replace analytic design. Compare analytic solution to empirical solution (plot?)

Include assessment of your calibration.

## 5.2. Heart rate sensor

No need to include the 10-bit ADC in this section.

# Bibliography

[1] M. J. Booysen, S. J. Andersen, and A. S. Zeeman, “Informal public transport in Sub-Saharan Africa as a vessel for novel Intelligent Transport Systems,” in 16th International IEEE Conference on Intelligent Transportation Systems (ITSC 2013), Oct 2013, pp.

767–772.

# Appendix A

# Social contract

Sign and inlcude.

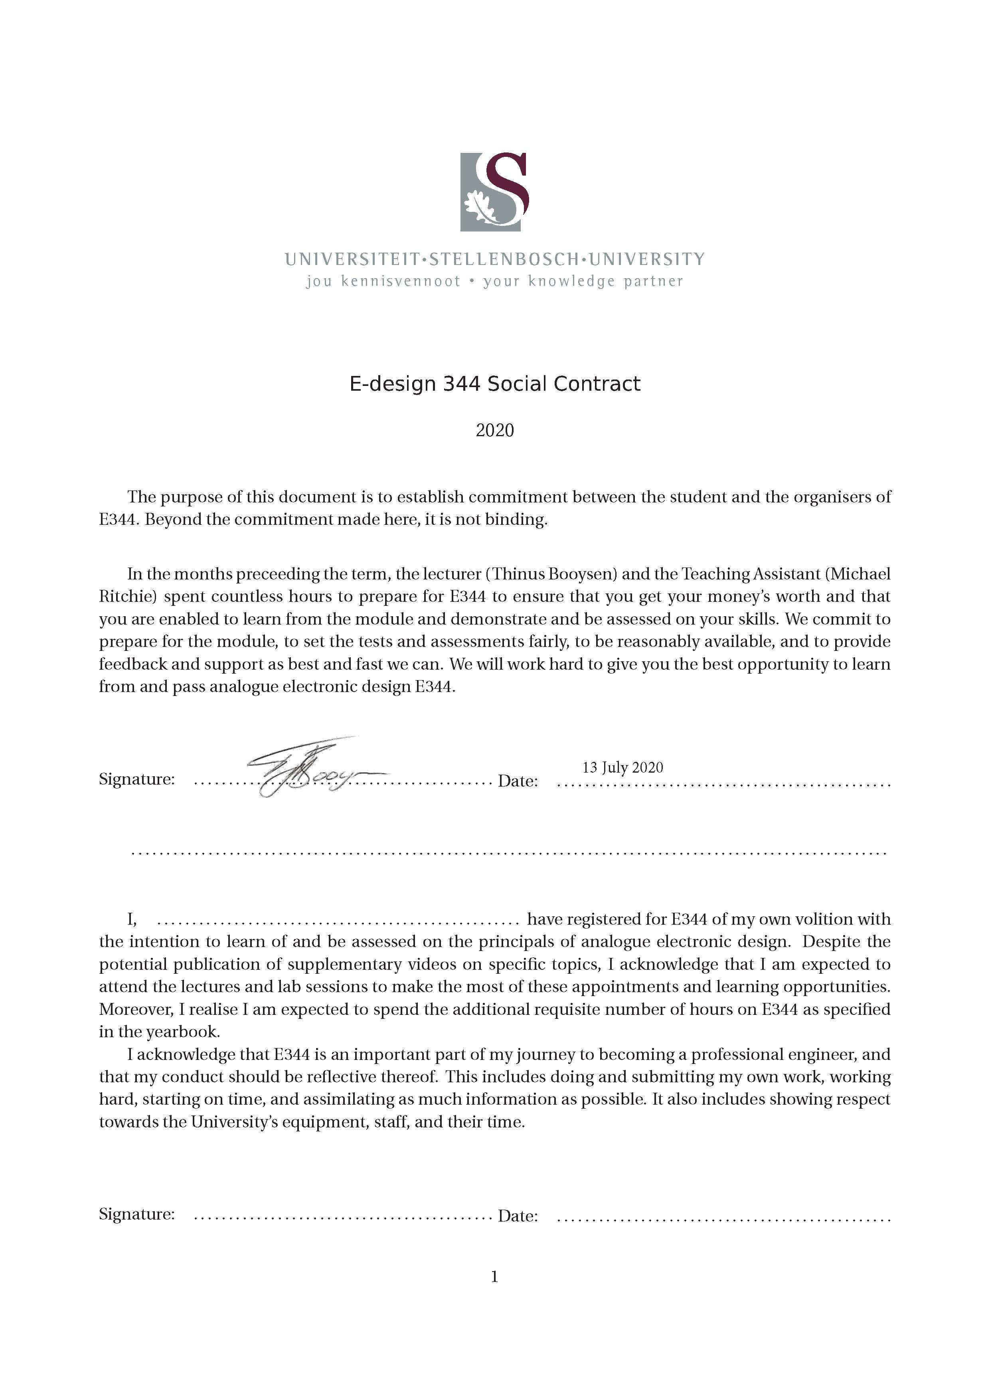
[picture p46: figure]

# Appendix B

# GitHub Activity Heatmap

Take a screenshot of your github version control activity heatmap and insert here.

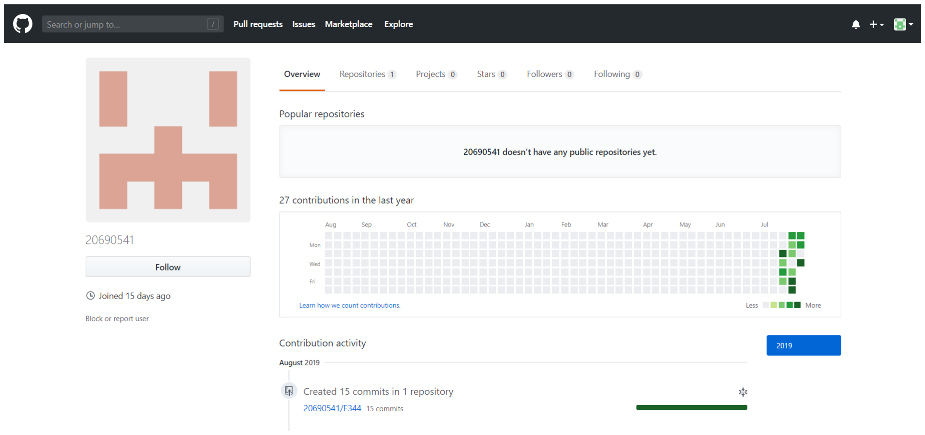
[picture p47: figure]

# Appendix C

# Stuff you want to include

remove this!! Lorem ipsum dolor sit amet, consectetuer adipiscing elit. Ut purus elit, vestibulum ut, placerat ac, adipiscing vitae, felis. Curabitur dictum gravida mauris. Nam arcu libero, nonummy eget, consectetuer id, vulputate a, magna. Donec vehicula augue eu neque. Pellentesque habitant morbi tristique senectus et netus et malesuada fames ac turpis egestas. Mauris ut leo. Cras viverra metus rhoncus sem. Nulla et lectus vestibulum urna fringilla ultrices. Phasellus eu tellus sit amet tortor gravida placerat. Integer sapien est, iaculis in, pretium quis, viverra ac, nunc. Praesent eget sem vel leo ultrices bibendum. Aenean faucibus. Morbi dolor nulla, malesuada eu, pulvinar at, mollis ac, nulla. Curabitur auctor semper nulla. Donec varius orci eget risus. Duis nibh mi, congue eu, accumsan eleifend, sagittis quis, diam. Duis eget orci sit amet orci dignissim rutrum.
Nam dui ligula, fringilla a, euismod sodales, sollicitudin vel, wisi. Morbi auctor lorem non justo. Nam lacus libero, pretium at, lobortis vitae, ultricies et, tellus. Donec aliquet, tortor sed accumsan bibendum, erat ligula aliquet magna, vitae ornare odio metus a mi. Morbi ac orci et nisl hendrerit mollis. Suspendisse ut massa. Cras nec ante. Pellentesque a nulla. Cum sociis natoque penatibus et magnis dis parturient montes, nascetur ridiculus mus. Aliquam tincidunt urna. Nulla ullamcorper vestibulum turpis. Pellentesque cursus luctus mauris. Nulla malesuada porttitor diam. Donec felis erat, congue non, volutpat at, tincidunt tristique, libero. Vivamus viverra fermentum felis. Donec nonummy pellentesque ante. Phasellus adipiscing semper elit. Proin fermentum massa ac quam. Sed diam turpis, molestie vitae, placerat a, molestie nec, leo. Maecenas lacinia. Nam ipsum ligula, eleifend at, accumsan nec, suscipit a, ipsum. Morbi blandit ligula feugiat magna. Nunc eleifend consequat lorem. Sed lacinia nulla vitae enim. Pellentesque tincidunt purus vel magna. Integer non enim. Praesent euismod nunc eu purus. Donec bibendum quam in tellus. Nullam cursus pulvinar lectus. Donec et mi. Nam vulputate metus eu enim. Vestibulum pellentesque felis eu massa. Quisque ullamcorper placerat ipsum. Cras nibh. Morbi vel justo vitae lacus tincidunt ultrices. Lorem ipsum dolor sit amet, consectetuer adipiscing elit. In hac habitasse platea dictumst. Integer tempus convallis augue. Etiam facilisis. Nunc elementum fermentum wisi. Aenean placerat. Ut imperdiet, enim sed gravida sollicitudin, felis odio placerat quam, ac pulvinar elit purus eget enim. Nunc vitae tortor. Proin tempus nibh sit amet nisl. Vivamus quis tortor vitae risus porta vehicula.
Fusce mauris. Vestibulum luctus nibh at lectus. Sed bibendum, nulla a faucibus semper, leo velit ultricies tellus, ac venenatis arcu wisi vel nisl. Vestibulum diam. Aliquam pellentesque, augue quis sagittis posuere, turpis lacus congue quam, in hendrerit risus eros eget felis.

Maecenas eget erat in sapien mattis porttitor. Vestibulum porttitor. Nulla facilisi. Sed a turpis eu lacus commodo facilisis. Morbi fringilla, wisi in dignissim interdum, justo lectus sagittis dui, et vehicula libero dui cursus dui. Mauris tempor ligula sed lacus. Duis cursus enim ut augue. Cras ac magna. Cras nulla. Nulla egestas. Curabitur a leo. Quisque egestas wisi eget nunc. Nam feugiat lacus vel est. Curabitur consectetuer.
Suspendisse vel felis. Ut lorem lorem, interdum eu, tincidunt sit amet, laoreet vitae, arcu. Aenean faucibus pede eu ante. Praesent enim elit, rutrum at, molestie non, nonummy vel, nisl. Ut lectus eros, malesuada sit amet, fermentum eu, sodales cursus, magna. Donec eu purus. Quisque vehicula, urna sed ultricies auctor, pede lorem egestas dui, et convallis elit erat sed nulla. Donec luctus. Curabitur et nunc. Aliquam dolor odio, commodo pretium, ultricies non, pharetra in, velit. Integer arcu est, nonummy in, fermentum faucibus, egestas vel, odio. Sed commodo posuere pede. Mauris ut est. Ut quis purus. Sed ac odio. Sed vehicula hendrerit sem. Duis non odio. Morbi ut dui. Sed accumsan risus eget odio. In hac habitasse platea dictumst. Pellentesque non elit. Fusce sed justo eu urna porta tincidunt. Mauris felis odio, sollicitudin sed, volutpat a, ornare ac, erat. Morbi quis dolor. Donec pellentesque, erat ac sagittis semper, nunc dui lobortis purus, quis congue purus metus ultricies tellus. Proin et quam. Class aptent taciti sociosqu ad litora torquent per conubia nostra, per inceptos hymenaeos. Praesent sapien turpis, fermentum vel, eleifend faucibus, vehicula eu, lacus.
