Teslassian/E344/Reports/Assignment 1/_template.pdf

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

# E344 Assignment 1

## Daniel von Eschwege

21785155

Report submitted in partial fulfilment of the requirements of the module Design (E) 344 for the degree Baccalaureus in Engineering in the Department of Electrical and Electronic Engineering at Stellenbosch University.

## August 15, 2020

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

## Plagiaatverklaring / Plagiarism Declaration

1. Plagiaat is die oorneem en gebruik van die idees, materiaal en ander intellektuele eiendom van ander persone asof dit jou eie werk is.
Plagiarism is the use of ideas, material and other intellectual property of another’s work and to present is as my own.
2. Ek erken dat die pleeg van plagiaat ’n strafbare oortreding is aangesien dit ’n vorm van diefstal is.
I agree that plagiarism is a punishable offence because it constitutes theft.
3. Ek verstaan ook dat direkte vertalings plagiaat is.
I also understand that direct translations are plagiarism.
4. Dienooreenkomstig is alle aanhalings en bydraes vanuit enige bron (ingesluit die internet) volledig verwys (erken). Ek erken dat die woordelikse aanhaal van teks sonder aanhalingstekens (selfs al word die bron volledig erken) plagiaat is.
Accordingly all quotations and contributions from any source whatsoever (including the internet) have been cited fully. I understand that the reproduction of text without quotation marks (even when the source is cited) is plagiarism
5. Ek verklaar dat die werk in hierdie skryfstuk vervat, behalwe waar anders aangedui, my eie oorspronklike werk is en dat ek dit nie vantevore in die geheel of gedeeltelik ingehandig het vir bepunting in hierdie module/werkstuk of ’n ander module/werkstuk nie.

I declare that the work contained in this assignment, except where otherwise stated, is my original work and that I have not previously (in its entirety or in part) submitted it for grading in this module/assignment or another module/assignment.

21785155 Studentenommer / Student number | Handtekening / Signature
D.H. von Eschwege Voorletters en van / Initials and surname | August 15, 2020 Datum / Date

i

# Contents

Declaration | i
List of Figures | iii
List of Tables | iv
Nomenclature | v
1. System design | 1
2. Voltage regulation | 2
3. Temperature sensor conditioning circuit | 6
4. System and conclusion | 7
A. Social contract | 8
B. GitHub Activity Heatmap | 9
C. Stuff you want to include | 10

ii

# List of Figures

1.1. System diagram | | 1
2.1. Circuit diagrams of the two voltage regulators, and another irrelevant one . . . | 3
2.2. I am the short caption that appears in the List of Figures list | | 4

iii

# List of Tables

2.1. Example of a simple table | | 4
2.2. Example of another table | | 4

iv

# Nomenclature

Variables and functions

p(x) | Probability density function with respect to variable x.
P(A) | Probability of event A occurring.
ε | The Bayes error.
εu | The Bhattacharyya bound.
B | The Bhattacharyya distance.
s | An HMM state. A subscript is used to refer to a particular state, e.g. si refers to the i th state of an HMM.

S A set of HMM states.

F A set of frames.

of | Observation (feature) vector associated with frame f.
γs(of ) | A posteriori probability of the observation vector of being generated by HMM state s.
µ | Statistical mean vector.
Σ | Statistical covariance matrix.
L(S) | Log likelihood of the set of HMM states S generating the training set observation vectors assigned to the states in that set.
N (x|µ, Σ) | Multivariate Gaussian PDF with mean µ and covariance matrix Σ.
aij | The probability of a transition from HMM state si to state sj .
N | Total number of frames or number of tokens, depending on the context.
D | Number of deletion errors.
I | Number of insertion errors.
S | Number of substitution errors.

v

Acronyms and abbreviations

AE | Afrikaans English
AID | accent identification
ASR | automatic speech recognition
AST | African Speech Technology
CE | Cape Flats English
DCD | dialect-context-dependent
DNN | deep neural network
G2P | grapheme-to-phoneme
GMM | Gaussian mixture model
HMM | hidden Markov model
HTK | Hidden Markov Model Toolkit
IE | Indian South African English
IPA | International Phonetic Alphabet
LM | language model
LMS | language model scaling factor
MFCC | Mel-frequency cepstral coefficient
MLLR | maximum likelihood linear regression
OOV | out-of-vocabulary
PD | pronunciation dictionary
PDF | probability density function
SAE | South African English
SAMPA | Speech Assessment Methods Phonetic Alphabet

vi

# Chapter 1

# System design

## 1.1. System overview

Here you insert a block diagram of your voltage regulationa nd signal conditioning system. Try to explain what configiation you chose and why. There is no need to specify the capacitor and resistor values here, but you want to capture the higher-level functional arrangement you have opted for. The diagram ties together the other chapters in this report and helps the reader understand how you have connected the different funtional blocks together to produce the outputs. For example, a block could be “Differential amplifier” or “level shifting op-amp” or “Low-pass filter” or “Linear regulator” and the like. Please use a drawing application, such as draw.io, MS Visio, or Power Point and export it as a PDF, so it looks good. If you feel brave, draw them in LATEXusing Inkscape/TikZ. Fig. 1.1 is a bad example that is completely irrelevant and just holds space for your beautiful system diagram.

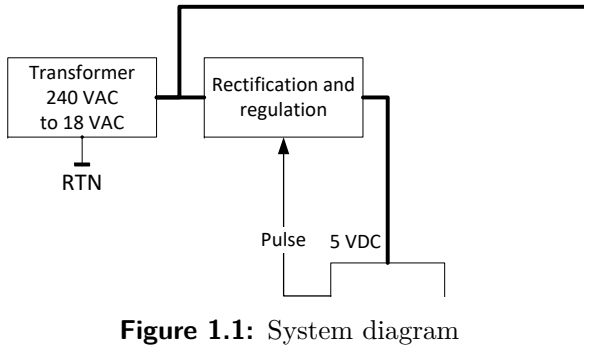
[picture p48: figure]
Rectification and regulation; Transformer 240 VAC to 18 VAC; Pulse; 5 VDC; RTN; Figure 1.1: System diagram

18 VAC

# Chapter 2

# Voltage regulation

## 2.1. Introduction

Introduce the reader to what you want to present in this chapter. Include any references to literature you feel is needed. In this section, you put a very short summary of infrormation you gatherered from literature (papers, web sites, datasheets) that you used to do the design. Be sure to include the references, which you can add in the References.bib file.
Some examples of how to cite (all in References.bib): It was stated by [?] that ... . Subsequently, he changed his mind and said in [?] that ... . While [?] claims it to be ... .

## 2.2. Design

In this section, you need to capture your design, which should include the following:

- Design rationale, i.e. what your thinking was behind the design.
- References to literature/sources as appropriate [?].
- You can assume the reader has an E&E degree, and will not need detail explanations of trivial information (e.g. what a resistor is, or what Ohm’s law is).
- Design calculations, for example to determine resistor values and capacitor values, or to check for allowed voltage and current ranges and levels. These calculations should also give expected outputs, which hopefully matches the simulated values.
- Analysis of given or expected input conditions.
- Expected values and ranges based on your design.
- Explain your choice of supply buy referring to the advantages and disadvantages of each.
- Circuit diagram like the one in Figure 2.1. I used “print to PDF” from LTSpice, but feel free to use a cropped screengrab if you are PDF-challenged and do not have a PDF printer (there are some free PDF creators online). Also have a look at the demo video on SUNLearn.

1
2

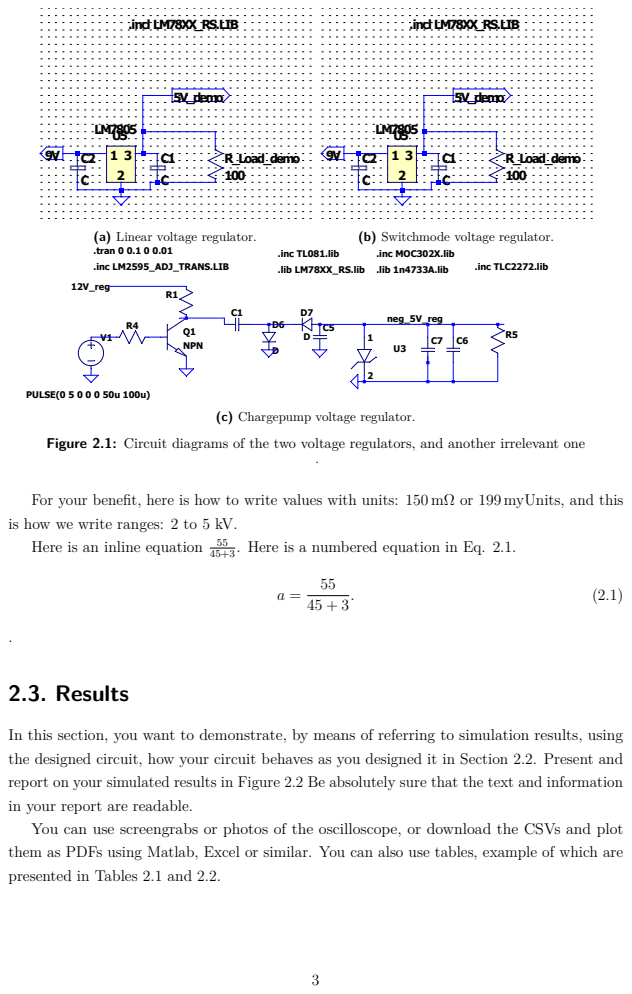
[picture p49: page 10]

.lib LM78XX_RS.lib .lib 1n4733A.lib

Figure 2.1: Circuit diagrams of the two voltage regulators, and another irrelevant one

For your benefit, here is how to write values with units: 150 mΩ or 199 myUnits, and this
is how we write ranges: 2 to 5 kV.
Here is an inline equation 55

45+3 . Here is a numbered equation in Eq. 2.1.

In this section, you want to demonstrate, by means of referring to simulation results, using
the designed circuit, how your circuit behaves as you designed it in Section 2.2. Present and
report on your simulated results in Figure 2.2 Be absolutely sure that the text and information
in your report are readable.
You can use screengrabs or photos of the oscilloscope, or download the CSVs and plot
them as PDFs using Matlab, Excel or similar. You can also use tables, example of which are
presented in Tables 2.1 and 2.2.

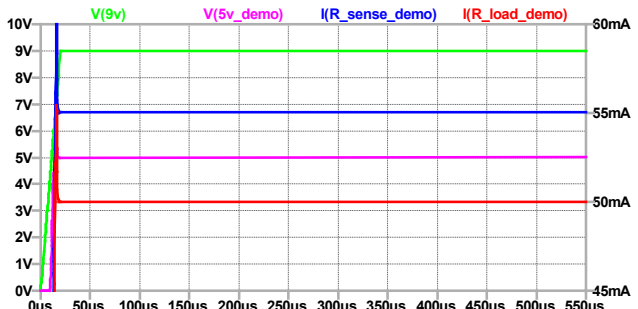
[picture p50: figure]
V(5v_demo); I(R_sense_demo); I(R_load_demo)

0µs 50µs 100µs 150µs 200µs 250µs 300µs 350µs 400µs 450µs 500µs 550µs

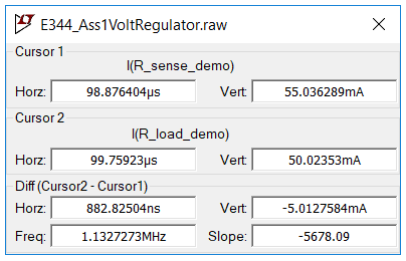
[picture p51: figure]

(b)

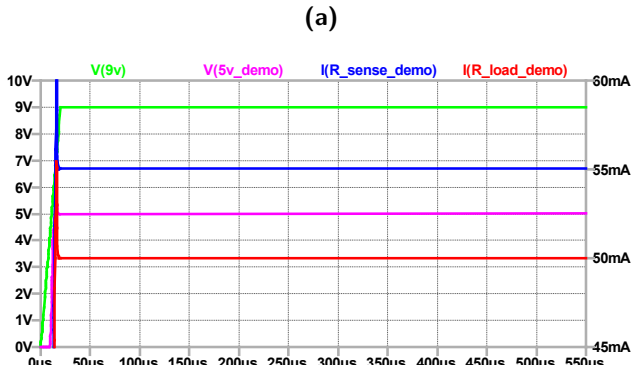
[picture p52: figure]
V(5v_demo); I(R_sense_demo); I(R_load_demo)

0µs 50µs 100µs 150µs 200µs 250µs 300µs 350µs 400µs 450µs 500µs 550µs

(c)

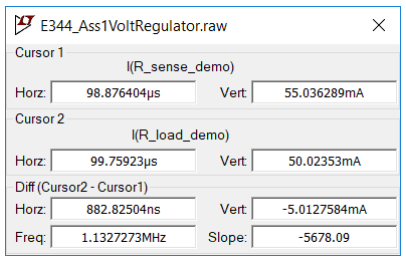
[picture p53: figure]

(d)

Figure 2.2: Voltage regulation, comparing the linear and switchmode regulators... (a) Blah blah. (b) Blah blah. (c) Blah blah. (d) Blah blah. As far as possible, please put input(s) and output(s) on the same plot rather than on separate plots. Based on the datasheet of XXXX in [?]

Table 2.1: Example of a simple table.

| 2017 | 2018 | ∆Abs | ∆DiD
A | 9,868 | 10,399 | +5 | -11
B | 10,191 | 10,590 | +4 | -12

Table 2.2: Example of another table.

Schools | Total energy used | Change
| 2017 | 2018 | ∆Abs | ∆DiD
| [kWh] | [kWh] | [%] | [%]
A | 9,868 | 10,399 | +5 | -11
B | 10,191 | 10,590 | +4 | -12

## 2.4. Summary

State whether your design performs as expected and what the limitations are or things to keep in mind are.

# Chapter 3

# Temperature sensor conditioning circuit

## 3.1. Intro

## 3.2. Design

## 3.3. Results

## 3.4. Summary

# Chapter 4

# System and conclusion

## 4.1. System

Report on the integration of the voltage regulator and temperature sensing circuitry. Report on noise levels and how the temperature sensor will fit into the system (E.g. what the calibration will look like and what the the measurement error will be given the range, quantisation error and noise).

## 4.2. Lessons learnt

Write down at least three of the most important things you have learnt in Assignment 1.

# Appendix A

# Social contract

Sign and inlcude.


# Appendix B

# GitHub Activity Heatmap

Take a screenshot of your github version control activity heatmap and insert here.


# Appendix C

# Stuff you want to include

Lorem ipsum dolor sit amet, consectetuer adipiscing elit. Ut purus elit, vestibulum ut, placerat ac, adipiscing vitae, felis. Curabitur dictum gravida mauris. Nam arcu libero, nonummy eget, consectetuer id, vulputate a, magna. Donec vehicula augue eu neque. Pellentesque habitant morbi tristique senectus et netus et malesuada fames ac turpis egestas. Mauris ut leo. Cras viverra metus rhoncus sem. Nulla et lectus vestibulum urna fringilla ultrices. Phasellus eu tellus sit amet tortor gravida placerat. Integer sapien est, iaculis in, pretium quis, viverra ac, nunc. Praesent eget sem vel leo ultrices bibendum. Aenean faucibus. Morbi dolor nulla, malesuada eu, pulvinar at, mollis ac, nulla. Curabitur auctor semper nulla. Donec varius orci eget risus. Duis nibh mi, congue eu, accumsan eleifend, sagittis quis, diam. Duis eget orci sit amet orci dignissim rutrum.
Nam dui ligula, fringilla a, euismod sodales, sollicitudin vel, wisi. Morbi auctor lorem non justo. Nam lacus libero, pretium at, lobortis vitae, ultricies et, tellus. Donec aliquet, tortor sed accumsan bibendum, erat ligula aliquet magna, vitae ornare odio metus a mi. Morbi ac orci et nisl hendrerit mollis. Suspendisse ut massa. Cras nec ante. Pellentesque a nulla. Cum sociis natoque penatibus et magnis dis parturient montes, nascetur ridiculus mus. Aliquam tincidunt urna. Nulla ullamcorper vestibulum turpis. Pellentesque cursus luctus mauris. Nulla malesuada porttitor diam. Donec felis erat, congue non, volutpat at, tincidunt tristique, libero. Vivamus viverra fermentum felis. Donec nonummy pellentesque ante. Phasellus adipiscing semper elit. Proin fermentum massa ac quam. Sed diam turpis, molestie vitae, placerat a, molestie nec, leo. Maecenas lacinia. Nam ipsum ligula, eleifend at, accumsan nec, suscipit a, ipsum. Morbi blandit ligula feugiat magna. Nunc eleifend consequat lorem. Sed lacinia nulla vitae enim. Pellentesque tincidunt purus vel magna. Integer non enim. Praesent euismod nunc eu purus. Donec bibendum quam in tellus. Nullam cursus pulvinar lectus. Donec et mi. Nam vulputate metus eu enim. Vestibulum pellentesque felis eu massa. Quisque ullamcorper placerat ipsum. Cras nibh. Morbi vel justo vitae lacus tincidunt ultrices. Lorem ipsum dolor sit amet, consectetuer adipiscing elit. In hac habitasse platea dictumst. Integer tempus convallis augue. Etiam facilisis. Nunc elementum fermentum wisi. Aenean placerat. Ut imperdiet, enim sed gravida sollicitudin, felis odio placerat quam, ac pulvinar elit purus eget enim. Nunc vitae tortor. Proin tempus nibh sit amet nisl. Vivamus quis tortor vitae risus porta vehicula.
Fusce mauris. Vestibulum luctus nibh at lectus. Sed bibendum, nulla a faucibus semper, leo velit ultricies tellus, ac venenatis arcu wisi vel nisl. Vestibulum diam. Aliquam pellentesque, augue quis sagittis posuere, turpis lacus congue quam, in hendrerit risus eros eget felis.

Maecenas eget erat in sapien mattis porttitor. Vestibulum porttitor. Nulla facilisi. Sed a turpis eu lacus commodo facilisis. Morbi fringilla, wisi in dignissim interdum, justo lectus sagittis dui, et vehicula libero dui cursus dui. Mauris tempor ligula sed lacus. Duis cursus enim ut augue. Cras ac magna. Cras nulla. Nulla egestas. Curabitur a leo. Quisque egestas wisi eget nunc. Nam feugiat lacus vel est. Curabitur consectetuer.
Suspendisse vel felis. Ut lorem lorem, interdum eu, tincidunt sit amet, laoreet vitae, arcu. Aenean faucibus pede eu ante. Praesent enim elit, rutrum at, molestie non, nonummy vel, nisl. Ut lectus eros, malesuada sit amet, fermentum eu, sodales cursus, magna. Donec eu purus. Quisque vehicula, urna sed ultricies auctor, pede lorem egestas dui, et convallis elit erat sed nulla. Donec luctus. Curabitur et nunc. Aliquam dolor odio, commodo pretium, ultricies non, pharetra in, velit. Integer arcu est, nonummy in, fermentum faucibus, egestas vel, odio. Sed commodo posuere pede. Mauris ut est. Ut quis purus. Sed ac odio. Sed vehicula hendrerit sem. Duis non odio. Morbi ut dui. Sed accumsan risus eget odio. In hac habitasse platea dictumst. Pellentesque non elit. Fusce sed justo eu urna porta tincidunt. Mauris felis odio, sollicitudin sed, volutpat a, ornare ac, erat. Morbi quis dolor. Donec pellentesque, erat ac sagittis semper, nunc dui lobortis purus, quis congue purus metus ultricies tellus. Proin et quam. Class aptent taciti sociosqu ad litora torquent per conubia nostra, per inceptos hymenaeos. Praesent sapien turpis, fermentum vel, eleifend faucibus, vehicula eu, lacus.
