Teslassian/E344/Reports/Ass3Template/frontmatter/skripsie_title_page.tex

\graphicspath{{frontmatter/fig/}}
\pagenumbering{Alph}

\begin{titlepage}
\begin{center}



\vfill

{\sffamily \bfseries \huge E344 Assignment 3 \par}

\vfill

{\large {\Large \nameFull} \\ \stNumber \par}

\vfill

\vfill

{Report submitted in partial fulfilment of the requirements of the module \\
Design (E) 344 for the degree Baccalaureus in Engineering in the Department of
Electrical and Electronic Engineering at Stellenbosch University. \par}

\vfill

%{\large {Supervisor}: Dr L. Skywalker} %\\
% Department of Electrical and Electronic Engineering \par}

\vfill

{\Large \myDate}
\end{center}
\end{titlepage}
