Teslassian/E344/Reports/Assignment 3/Figures/SocialContract_signed.pdf

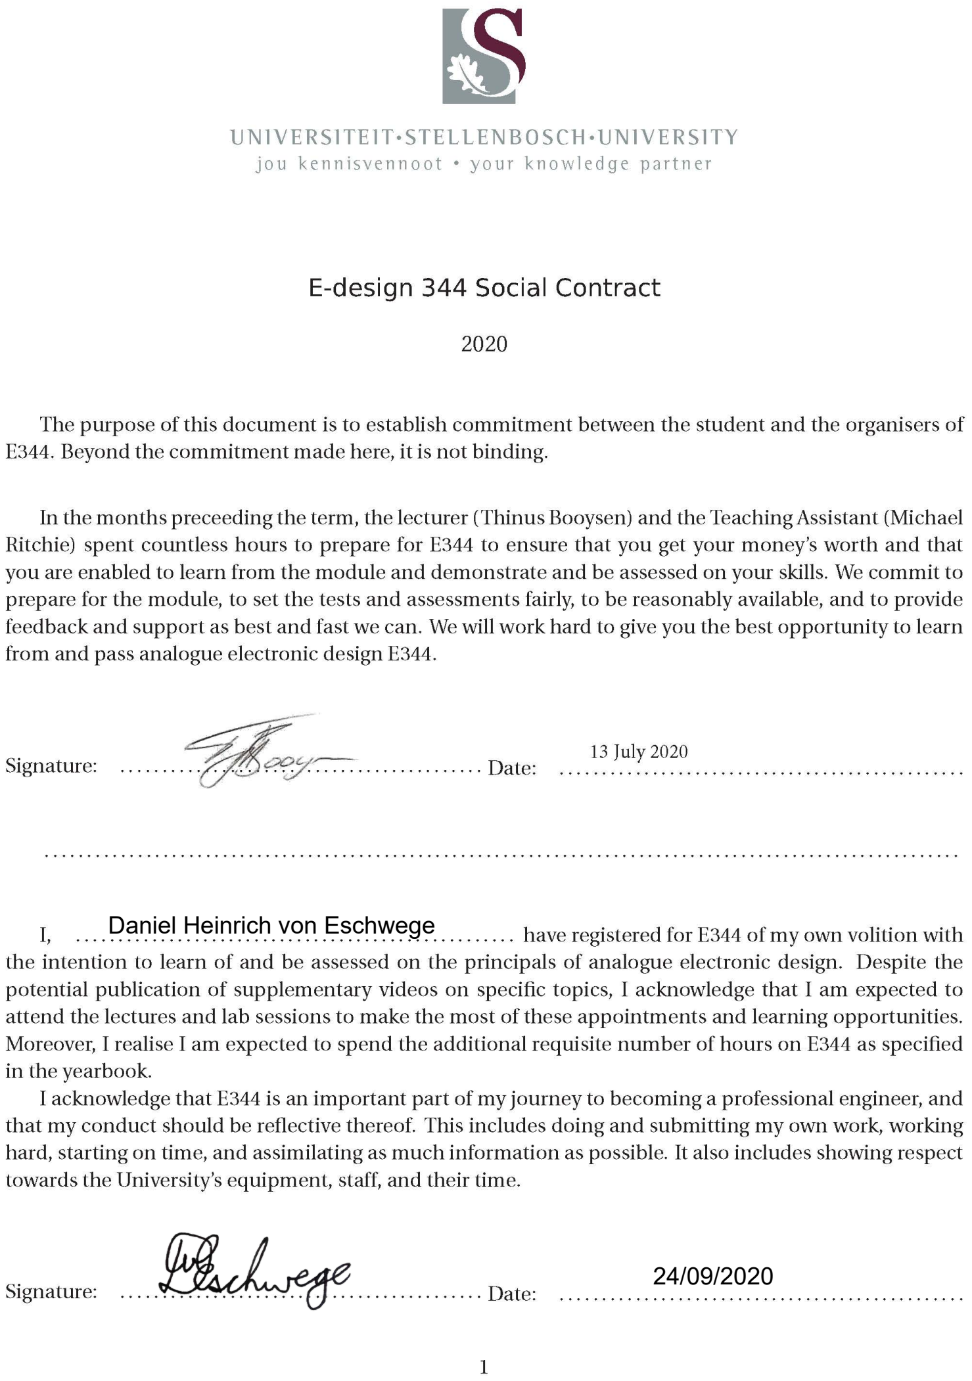
[picture p58: page 1]

24/09/2020

Daniel Heinrich von Eschwege
