Teslassian/E344/Reports/Assignment 3/Figures/lr.pdf

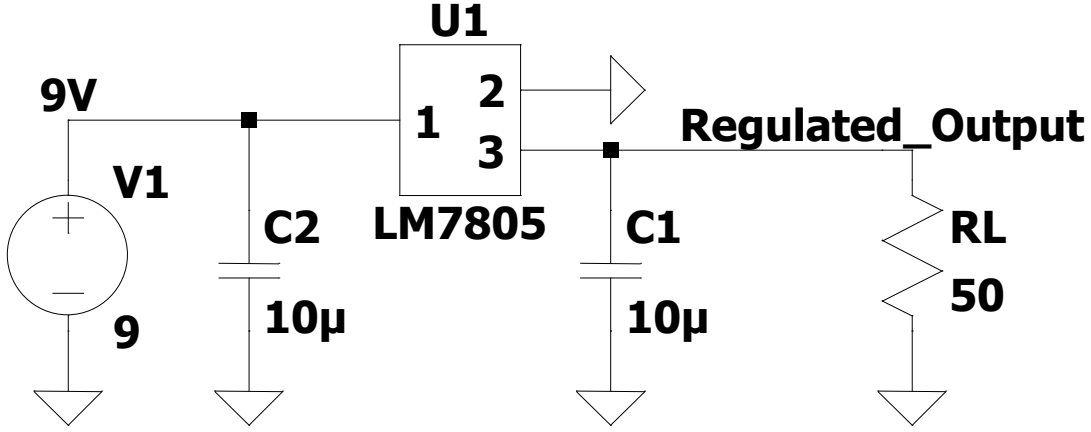
[picture p59: figure]
Regulated_Output
