Teslassian/E344/Reports/Assignment 3/Figures/SocialContract_signed (2).pdf

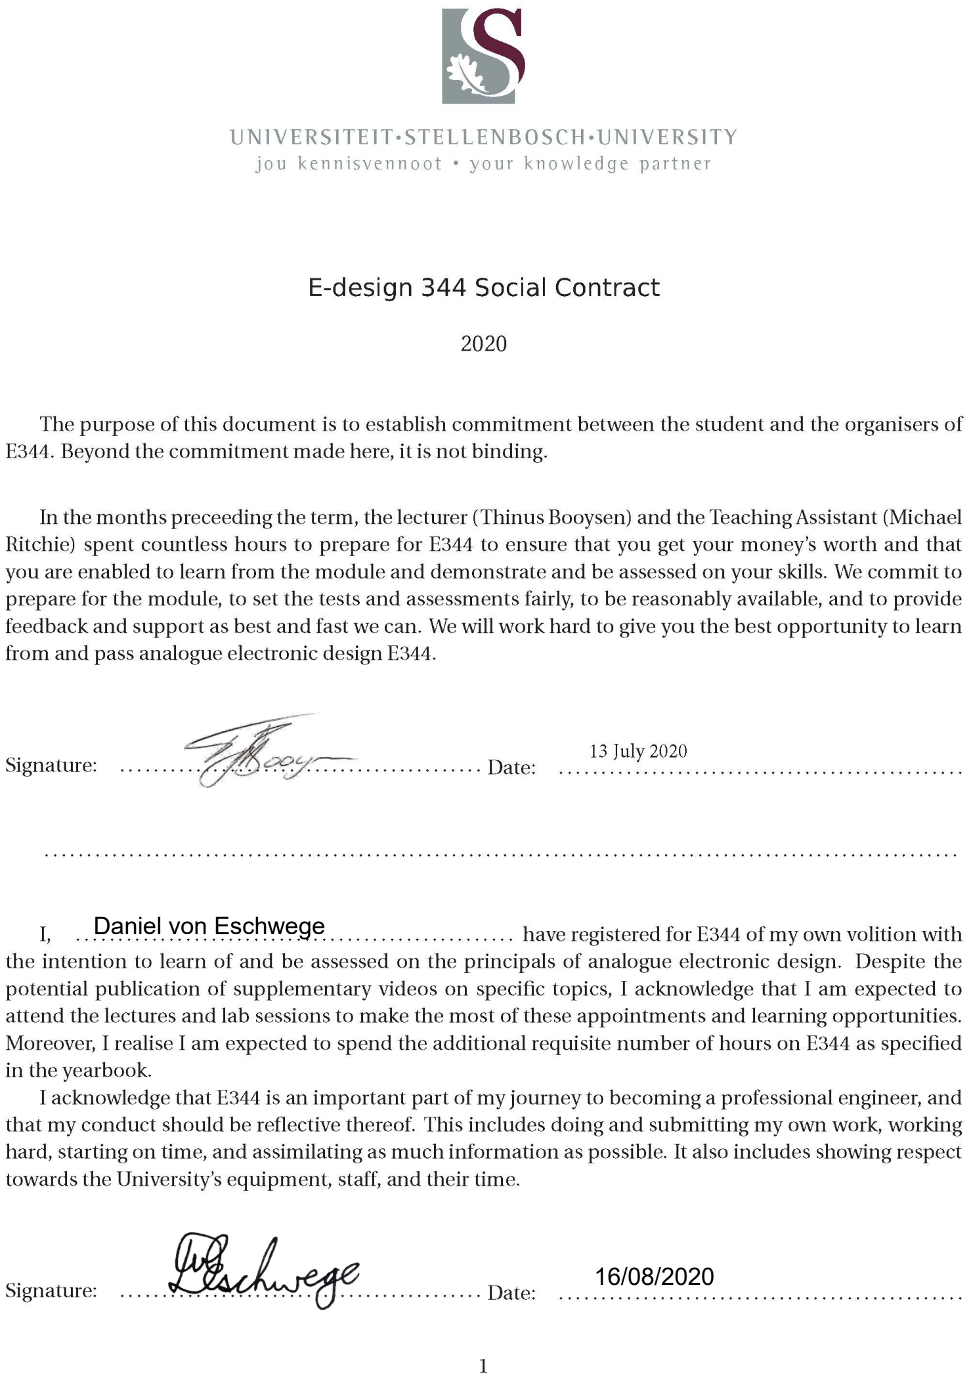
[picture p60: page 1]

Daniel von Eschwege

16/08/2020
