Teslassian/E344/Reports/Assignment 3/Figures/ac - Copy.png

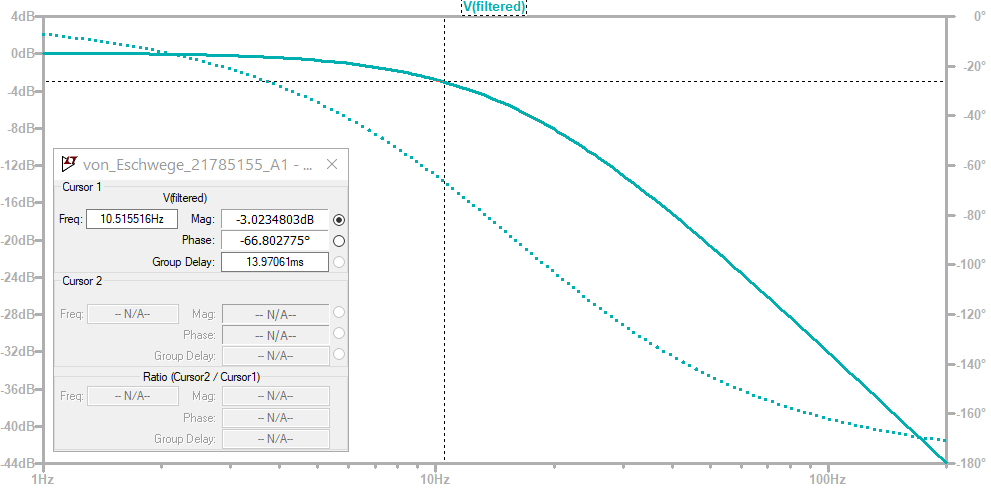
Reports/Assignment 3/Figures/ac - Copy.png
