Teslassian/E344/Reports/Assignment 3/Figures/circuit.png

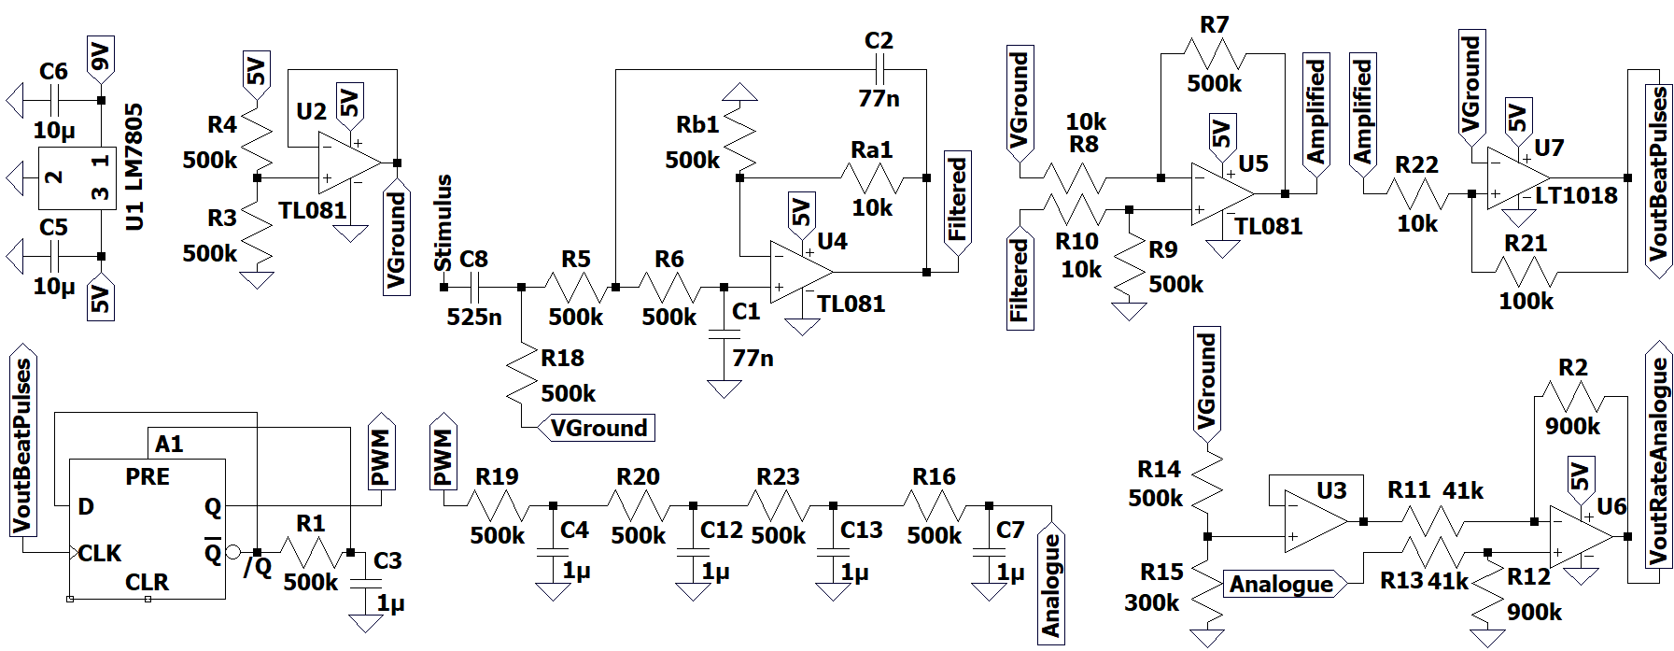
Reports/Assignment 3/Figures/circuit.png
