Teslassian/E344/Reports/Assignment 3/Figures/filtered.png

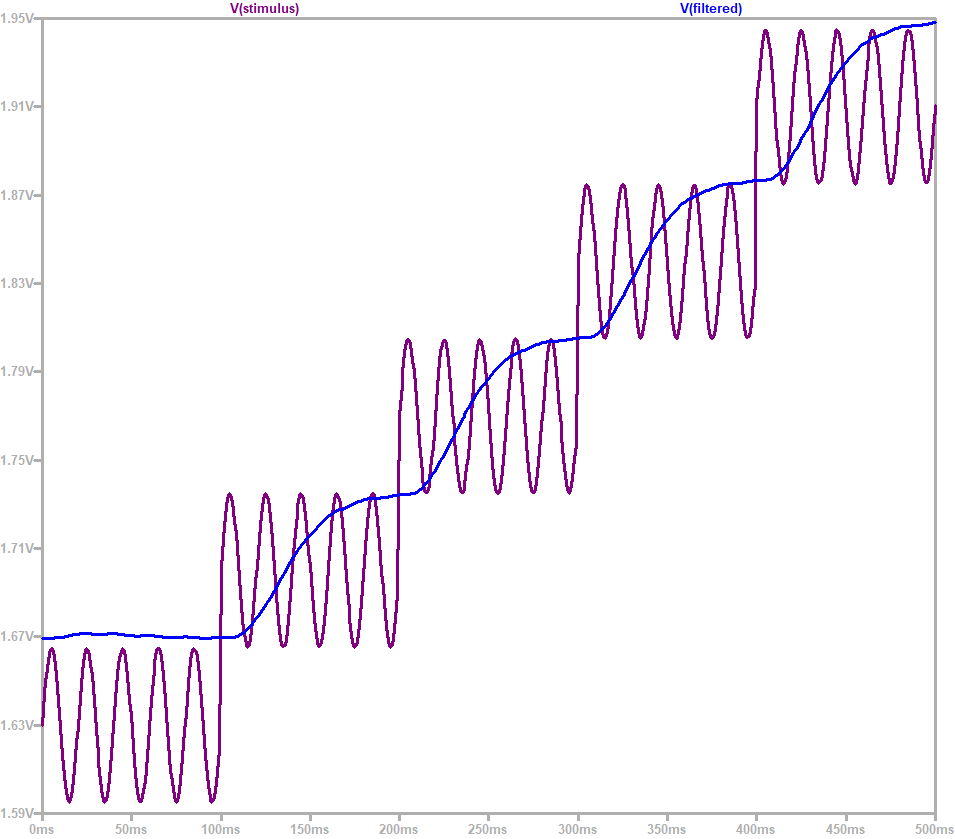
Reports/Assignment 3/Figures/filtered.png
