Teslassian/E344/Reports/Assignment 3/frontmatter/nomenclature.tex

\chapter*{Nomenclature\markboth{}{Nomenclature}}
\addcontentsline{toc}{chapter}{Nomenclature}

% \vspace*{-3mm}
\subsubsection*{Variables and functions}

\begingroup
\renewcommand{\arraystretch}{1.2}
\renewcommand{\tabularxcolumn}[1]{p{#1}}
\begin{tabularx}{\textwidth}{@{}p{2.5cm}L}
	$f_c$		& Cutoff frequency \\
	$V_{REF}$ 	& Reference voltage \\
	$A_v$		& Gain \\
	$\beta$ 	& Feedback fraction \\
	$V_{CM}$	& Common-mode voltage \\
	$V_{ID}$	& Differential-mode voltage \\
	$\eta$		& Efficiency\\
	$\omega_n$ 	& Natural Frequency\\
	$t_{r}$ 	& Rise time (90\%)\\
    $V_{ref}$ 	& Reference Voltage\\
\end{tabularx}
\endgroup

\newpage
\subsubsection*{Acronyms and abbreviations}

\begingroup
\renewcommand{\arraystretch}{1.2}
\begin{tabular}{@{}p{2.5cm} l}
	PWM		& Pulse-width modulation \\
	FFT		& Fast Fourier transform \\
	DC		& Direct Current \\
	Q-factor & Quality factor \\
	BPM		& Beats per minute \\
	UTP		& Upper trip point \\
	LTP		& Lower trip point \\
    AC      & Alternating Current\\
    DC      & Direct Current\\
    ADC      & Analog-to-Digital Converter\\
\end{tabular}
\endgroup
