Teslassian/E344/Reports/Ass3Template/frontmatter/nomenclature.tex

\chapter*{Nomenclature\markboth{}{Nomenclature }}
\addcontentsline{toc}{chapter}{Nomenclature}

\textcolor{red}{update these}
% \vspace*{-3mm}
\subsubsection*{Variables and functions}

\begingroup
\renewcommand{\arraystretch}{1.2}
\renewcommand{\tabularxcolumn}[1]{p{#1}}
\begin{tabularx}{\textwidth}{@{}p{2.5cm}L}
    $p(x)$ & Probability density function with respect to variable $x$.\\
    $P(A)$ & Probability of event $A$ occurring.\\
    $\varepsilon$ & The Bayes error. \\
    $\varepsilon_u$ & The Bhattacharyya bound. \\
    $B$ & The Bhattacharyya distance. \\
    $s$ & An HMM state.  A subscript is used to refer to a particular state, e.g.\ $s_i$ refers to the $i^{\text{th}}$ state of an HMM. \\
    $\mathbf{S}$ & A set of HMM states. \\
    $\mathbf{F}$ & A set of frames. \\
    $\mathbf{o}_f$ & Observation (feature) vector associated with frame $f$. \\
    $\gamma_s(\mathbf{o}_f)$ & A posteriori probability of the observation vector $\mathbf{o}_f$ being generated by HMM state $s$. \\
    $\mu$ & Statistical mean vector. \\
    $\Sigma$ & Statistical covariance matrix. \\
    $L(\mathbf{S})$ & Log likelihood of the set of HMM states $\mathbf{S}$ generating the training set observation vectors assigned to the states in that set. \\
    $\mathcal{N}(\mathbf{x} | \mu, \Sigma)$ & Multivariate Gaussian PDF with mean $\mu$ and covariance matrix $\Sigma$.\\
    $a_{ij}$ & The probability of a transition from HMM state $s_i$ to state $s_j$. \\
    $N$ & Total number of frames or number of tokens, depending on the context. \\
    $D$ & Number of deletion errors. \\
    $I$ & Number of insertion errors. \\
    $S$ & Number of substitution errors. \\
\end{tabularx}
\endgroup

\newpage
\subsubsection*{Acronyms and abbreviations}
\textcolor{red}{update this}\\
\begingroup
\renewcommand{\arraystretch}{1.2}
\begin{tabular}{@{}p{2.5cm} l}
    AE      & Afrikaans English \\
    AID     & accent identification \\
    ASR     & automatic speech recognition \\
    AST     & African Speech Technology \\
    CE      & Cape Flats English \\
    DCD     & dialect-context-dependent \\
    DNN		& deep neural network \\
    G2P     & grapheme-to-phoneme \\
    GMM     & Gaussian mixture model \\
    HMM     & hidden Markov model \\
    HTK     & Hidden Markov Model Toolkit \\
    IE      & Indian South African English \\
    IPA     & International Phonetic Alphabet \\
    LM      & language model \\
    LMS     & language model scaling factor \\
    MFCC    & Mel-frequency cepstral coefficient \\
    MLLR    & maximum likelihood linear regression \\
    OOV     & out-of-vocabulary \\
    PD      & pronunciation dictionary \\
    PDF     & probability density function \\
    SAE     & South African English \\
    SAMPA   & Speech Assessment Methods Phonetic Alphabet \\
\end{tabular}
\endgroup
