Teslassian/E344/Reports/Assignment 3/Figures/sm.pdf

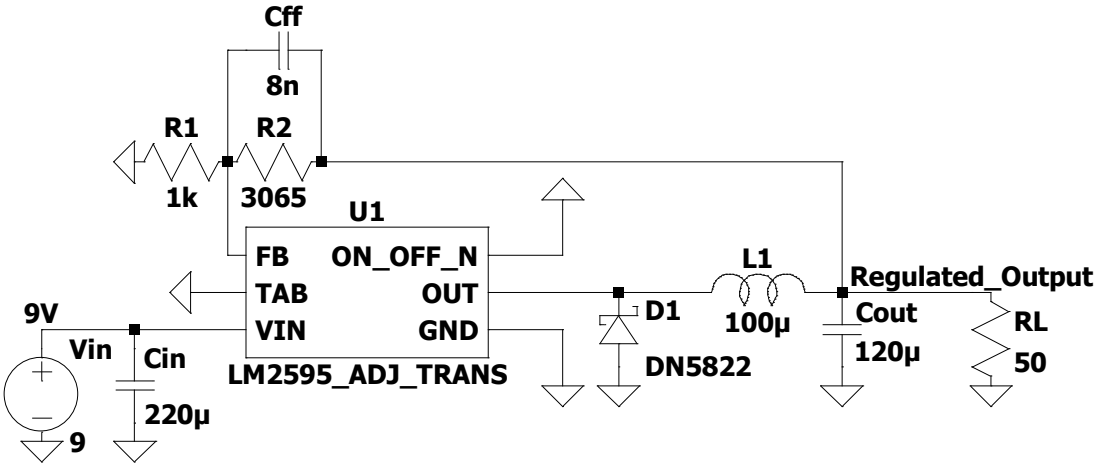
[picture p64: page 1]
Cout; Cin; RL 50 Vin; Cff; FB TAB VIN; ON_OFF_N OUT GND; LM2595_ADJ_TRANS; Regulated_Output
