Teslassian/E344/LTSpice/Assignment 2/Test.asc

C1: cap; 0.1µ
C2: cap; 0.33µ
C3: cap; 150n
C4: cap; 150n
R1: res; 300k
R2: res; 300k
R3: res; 1000k
R4: res; 10k
U1: LM7805
U2: opamp2; TL081
V1: voltage; 9; Rser=0.01
V2: voltage; SINE(0.5 0.01 1); AC 0.01
Named nets: 0, 5V, lpf_out_meas
E. Stewdent.,  00024601
DC = 500 mV
Heart rate pk = 10 mV
.include TLC2272.LIB
.include TL081.LIB
.tran 30
