Teslassian/E344/LTSpice/Temperature Sensor Circuits/_Noninverting_1st_Order_TL081.asc

C1: cap; 159n
R4: res; 50k
R_Sense: res; 0.010
U1: opamp2; TL081
V1: voltage; {dcAmplitude}
V2: voltage; PWL file=PWLinput.csv
V3: voltage; SINE({sineOffset} {sineAmplitude} {sineFreq})
V4: voltage; 9
V5: voltage; 5
Named nets: 0, Stimulus, 9V, Vout, Filtered
.tran 0 {transtop} 0 {timestep}
.include E344cfg.txt
Don't change these -- used for auto-assessments.
You may modify input files while developing.
For submission: 
  * Use only 9V supply 
  * Connect "Stimulus" to your input
  * Connect "Vout" to your output.
  * Only one label name per net.
Config file:
Analysis setup:
Battery
Sensor-
emulating 
stimulus
Assessed nets:
Connect to your outputs
E. Stewdent.,  00024601
V(0degV) = 500 mV
deltaV/degV = 10 mV
.incl TL081.lib
