Teslassian/E344/LTSpice/Temperature Sensor Circuits/_Sensor_TLC2272_1stOrder_TL081.asc

C1: cap; 10µ
C2: cap; 10µ
C3: cap; 159n
R1: res; 10k
R2: res; 10k
R3: res; 220k
R4: res; 220k
R5: res; 10k
R6: res; 4765
R8: res; 50k
R_Sense: res; 0.010
Rload: res; 100k
U1: opamp2; TLC2272
U2: LM7805
U3: opamp2; TL081
V1: voltage; {dcAmplitude}
V2: voltage; PWL file=PWLinput.csv
V3: voltage; SINE({sineOffset} {sineAmplitude} {sineFreq})
V4: voltage; 9
V5: voltage; SINE(1.77 0.14 50)
Named nets: Vout, 0, Stimulus, 9V, Filtered
.tran 0 {transtop} 0 {timestep}
.include E344cfg.txt
Don't change these -- used for auto-assessments.
You may modify input files while developing.
For submission: 
  * Use only 9V supply 
  * Connect "Stimulus" to your input
  * Connect "Vout" to your output.
  * Only one label name per net.
Config file:
Analysis setup:
Battery
Sensor-
emulating 
stimulus
Assessed nets:
Connect to your outputs
D. H. von Eschwege, 21785155
V(0degV) = 440mV
deltaV/degV = 35mV
.incl TLC2272.lib
.incl LM78XX_RS.lib
.incl TL081.lib
