Teslassian/E344/LTSpice/Assignment 1/Temperature Sensor Circuits/Cutoff Frequency Measurement/von_Eschwege_21785155_A1 - fc.asc

C3: cap; 100n
C4: cap; 100n
C5: cap; 100n
C6: cap; 100n
R1: res; 100k
R7: res; 100k
R9: res; 100k
R10: res; 100k
R_Sense: res; 0.010
Ra1: res; 5k
Ra: res; 5k
Rb1: res; 500k
Rb: res; 500k
U3: opamp2; TL081
U4: opamp2; TL081
V1: voltage; {dcAmplitude}
V2: voltage; PWL file=PWLinput.csv
V3: voltage; SINE({sineOffset} {sineAmplitude} {sineFreq})
V4: voltage; 9
V5: voltage; 2.5; AC 1
V6: voltage; 5
Named nets: 0, Stimulus, 9V, Vout, 5V, filtered, vout
;tran 0 {transtop} 0 {timestep}
.include E344cfg.txt
Don't change these -- used for auto-assessments.
You may modify input files while developing.
For submission: 
  * Use only 9V supply 
  * Connect "Stimulus" to your input
  * Connect "Vout" to your output.
  * Only one label name per net.
Config file:
Analysis setup:
Battery
Sensor-
emulating 
stimulus
Assessed nets:
Connect to your outputs
D. H. von Eschwege, 21785155
V(0degV) = 440mV
deltaV/degV = 35mV
.incl TLC2272.lib
.incl LM78XX_RS.lib
.incl TL081.lib
.ac dec 300 1 200
