Teslassian/E344/LTSpice/Assignment 1/Temperature Sensor Circuits/Noise Measurement/von_Eschwege_21785155_A1 - noise.asc

C1: cap; 10µ
C2: cap; 10µ
C3: cap; 100n
C4: cap; 100n
C5: cap; 100n
C6: cap; 100n
R1: res; 100k
R7: res; 100k
R8: res; 100k
R9: res; 100k
R10: res; 100k
R_Sense: res; 0.010
Ra1: res; 100
Ra: res; 100
Rb1: res; 500k
Rb: res; 500k
U2: LM7805
U3: opamp2; TL081
U4: opamp2; TL081
V1: voltage; {dcAmplitude}
V2: voltage; PWL file=PWLinput.csv
V3: voltage; SINE({sineOffset} {sineAmplitude} {sineFreq})
V4: voltage; 9
V5: voltage; SINE(2.5 0.035 50); AC 1
Named nets: 0, Stimulus, 9V, Vout, 5V, filtered, vout, vin
.tran 100m
.include E344cfg.txt
Don't change these -- used for auto-assessments.
You may modify input files while developing.
For submission: 
  * Use only 9V supply 
  * Connect "Stimulus" to your input
  * Connect "Vout" to your output.
  * Only one label name per net.
Config file:
Analysis setup:
Battery
Sensor-
emulating 
stimulus
Assessed nets:
Connect to your outputs
D. H. von Eschwege, 21785155
V(0degV) = 440mV
deltaV/degV = 35mV
.incl TLC2272.lib
.incl LM78XX_RS.lib
.incl TL081.lib
