Teslassian/E344/LTSpice/Assignment 2/bruh.asc

C1: cap; 77n
C2: cap; 77n
C5: cap; 10µ
C6: cap; 10µ
C8: cap; 525n
R3: res; 500k
R4: res; 500k
R5: res; 500k
R6: res; 500k
R7: res; 500k
R8: res; 10k
R9: res; 500k
R10: res; 10k
R18: res; 500k
R21: res; 100k
R22: res; 10k
R_Sense1: res; 0.010
Ra1: res; 10k
Rb1: res; 500k
U1: LM7805
U2: opamp2; TL081
U4: opamp2; TL081
U5: opamp2; TL081
U7: LT1018
V5: voltage; PWL file=bruh.csv
V6: voltage; SINE({sineOffset} {sineAmplitude} {sineFreq})
V7: voltage; {dcAmplitude}
V8: voltage; 9
Named nets: 0, 9V, 5V, VGround, Stimulus, VoutBeatPulses, Filtered, Amplified, VoutRateAnalogue
D.H. von Eschwege,  21785155
DC = 2 V
Heart rate pk = 38.85 mV
.incl TLC2272.lib
.incl LM78XX_RS.lib
.incl TL081.lib
.options numdgt = 7
.options plotwinsize = 0
.lib opamp.sub
.tran 0 6 0 {timestep}
.include E344cfg.txt
Don't change these -- used for auto-assessments.
You may modify input files while developing.
For submission: 
  * Use only 9V supply 
  * Connect "Stimulus" to your input
  * Connect "VoutXXXX" to your output signals.
  * Only one label name per net.
Config file:
Analysis setup:
Battery
Sensor-
emulating 
stimulus
Assessed nets:
Connect to your outputs
