Teslassian/E344/Python/Assignment3/E344_A3_heart.asc

C1: cap; 77n
C2: cap; 77n
C3: cap; 525n
C4: cap; 10µ
C5: cap; 10µ
R1: res; 500k
R2: res; 500k
R3: res; 500k
R4: res; 500k
R5: res; 500k
R6: res; 10.5k
R7: res; 500k
R8: res; 10.5k
R9: res; 500k
R10: res; 100k
R11: res; 10k
R_Sense: res; 0.010
Ra1: res; 10k
Rb1: res; 500k
U2: LM7805
U5: opamp2; TL081
U6: opamp2; TL081
U7: opamp2; TL081
U8: LT1018
V1: voltage; PWL file=HeartSensorPWL.csv
V4: voltage; 9
Named nets: 0, Vheartsensor, 9V, Vheartpulsesout, 5V, VGround, Filtered, Amplified
.tran 0 {transtop} 0 {timestep}
.include A3heartcfg.txt
Don't change these -- used for auto-assessments.
You may modify input files while developing.
For submission: 
  * Use only 9V supply 
  * Connect "Vheartsensor" to your 
               conditioning circuit's input
  * Connect "Vheartpulsesout" to your output signal.
  * Only one label name per net.
Config file:
Analysis setup:
Battery
Sensor-
emulating 
stimulus
=============================
REPLACE WITH YOUR DETAILS
D.H. von Eschwege., 21785155
Vheartsensor offset = 2V
Vheartsensor ampl = 38.85 mV
=============================
==========================================================================================
Heart signal conditioning circuit (only copy and paste the given op-amps, or use those given in the working directory only)
==========================================================================================
=============================
Voltage regulation (complete this)
=============================
.incl TLC2272.LIB
.incl TL081.LIB
.incl LM78XX_RS.lib
Connect to your conditioning circuit's output
=============================
Includes (don't fiddle with this!!)
=============================
change these CAPS!!!
