Teslassian/E344/Python/Assignment3/E344_A3_temp.asc

C1: cap; 100n
C2: cap; 100n
C3: cap; 100n
C4: cap; 100n
C5: cap; 10µ
C6: cap; 10µ
R1: res; 230k
R2: res; 10k
R3: res; 5105
R4: res; 10k
R5: res; 230k
R6: res; 10k
R7: res; 100k
R8: res; 100k
R9: res; 100k
R10: res; 100k
R_Sense: res; 0.010
Ra1: res; 5k
Ra2: res; 5k
Rb1: res; 500k
Rb2: res; 500k
Rload1: res; 100k
U2: LM7805
U4: opamp2; TL081
U5: opamp2; TL081
U6: opamp2; TLC2272
V1: voltage; PWL file=TempSensorPWL.csv
V4: voltage; 9
Named nets: 0, Vtempsensor, 9V, Vtempoutadc, 5V, V_diffamp, LPF1_out, LPF2_out
.tran 0 {transtop} 0 {timestep}
.include A3tempcfg.txt
Don't change these -- used for auto-assessments.
You may modify input files while developing.
For submission: 
  * Use only 9V supply 
  * Connect "Vtempsensor" to your 
               conditioning circuit's input
  * Connect "VtempoutADC" to your output signal.
  * Only one label name per net.
Config file:
Analysis setup:
Battery
Sensor-
emulating 
stimulus
=============================
REPLACE WITH YOUR DETAILS
D.H. von Eschwege.,  21785155
Vtempsensor for 0degC = 440 mV
delta Vtempsensor = 35 mV/degC
=============================
==========================================================================================
Temperature conditioning circuit (only copy and paste the given op-amps, or use those given in the working directory only)
==========================================================================================
=============================
Voltage regulation (complete this)
=============================
.incl TLC2272.LIB
.incl TL081.LIB
.incl LM78XX_RS.lib
Connect to your conditioning circuit's output
=============================
Includes (don't fiddle with this!!)
=============================
change these CAPS!!!
