Teslassian/E344/LTSpice/Assignment 2/von_Eschwege_21785155_A2.asc

A1: dflop; Vhigh 5 Trise 10n
C1: cap; 77n
C2: cap; 77n
C3: cap; 1µ
C4: cap; 1µ
C5: cap; 10µ
C6: cap; 10µ
C7: cap; 1µ
C8: cap; 525n
C12: cap; 1µ
C13: cap; 1µ
R1: res; 500k
R2: res; 900k
R3: res; 500k
R4: res; 500k
R5: res; 500k
R6: res; 500k
R7: res; 500k
R8: res; 10k
R9: res; 500k
R10: res; 10k
R11: res; 41k
R12: res; 900k
R13: res; 41k
R14: res; 500k; tol=60k
R15: res; 300k
R16: res; 500k
R18: res; 500k
R19: res; 500k
R20: res; 500k
R21: res; 100k
R22: res; 10k
R23: res; 500k
R_Sense1: res; 0.010
Ra1: res; 10k
Rb1: res; 500k
U1: LM7805
U2: opamp2; TL081
U3: opamp
U4: opamp2; TL081
U5: opamp2; TL081
U6: UniversalOpamp2
U7: LT1018
V5: voltage; PWL file=90.csv
V6: voltage; SINE({sineOffset} {sineAmplitude} {sineFreq})
V7: voltage; {dcAmplitude}
V8: voltage; 9
Named nets: 0, 9V, 5V, VGround, Stimulus, VoutBeatPulses, /Q, Filtered, Amplified, PWM, Analogue, VoutRateAnalogue, rc
D.H. von Eschwege,  21785155
DC = 2 V
Heart rate pk = 38.85 mV
.incl TLC2272.lib
.incl LM78XX_RS.lib
.incl TL081.lib
.options numdgt = 7
.options plotwinsize = 0
.lib opamp.sub
.tran 0 {transtop} 0 {timestep} UIC
.include E344cfg.txt
Don't change these -- used for auto-assessments.
You may modify input files while developing.
For submission: 
  * Use only 9V supply 
  * Connect "Stimulus" to your input
  * Connect "VoutXXXX" to your output signals.
  * Only one label name per net.
Config file:
Analysis setup:
Battery
Sensor-
emulating 
stimulus
Assessed nets:
Connect to your outputs
