Teslassian/E344/LTSpice/Temperature Sensor Circuits/Draft3.asc

C1: cap; 318.31n
R1: res; 10k
R2: res; 10k
R3: res; 100k
U1: opamp2; TL081
V1: voltage; SINE(2.5 1 50)
V2: voltage; 5
Named nets: 0
.incl TL081.lib
.tran 500ms
