Teslassian/E344/LTSpice/Assignment 1/Temperature Sensor Circuits/neat.asc

C1: cap; 10µ
C2: cap; 10µ
C3: cap; 100n
C4: cap; 100n
C5: cap; 100n
C6: cap; 100n
R1: res; 10k
R2: res; 10k
R3: res; 230k
R4: res; 230k
R5: res; 10k
R6: res; 5105
R7: res; 100k
R8: res; 100k
R9: res; 100k
R10: res; 100k
Ra1: res; 5k
Ra: res; 5k
Rb1: res; 500k
Rb: res; 500k
Rload: res; 100k
U1: opamp2; TLC2272
U2: LM7805
U3: opamp2; TL081
U4: opamp2; TL081
Named nets: Vout, 9V, 0, Stimulus, 5V, Filtered_1, Filtered_2
