Teslassian/E344/LTSpice/Assignment 1/Voltage Regulators/_LM2595_Switchmode_Regulator.asc

Cff: cap; 8n
Cin: cap; 220µ
Cout: cap; 120µ
D1: schottky; DN5822
L1: ind; 100µ
R1: res; 1k
R2: res; 3065
Rout: res; 50
U1: LM2595_ADJ_TRANS
Vin: voltage; 9
Named nets: 0, 9V, 5V
.incl LM2595_ADJ_TRANS.lib
.incl DN5822.lib
.tran 0 5m 0
