Teslassian/E344/LTSpice/Assignment 1/Voltage Regulators/_LM7805_Linear_Regulator.asc

C1: cap; 10µ
C2: cap; 10µ
Rout: res; 50
U1: LM7805
Vin: voltage; 9
Named nets: 0, 9V, 5V
.incl LM78XX_RS.lib
.tran 10m
