Teslassian/E344/(commit log)

2020-08-08 Created folder structure and added templates
    [PWLinput.csv]
2020-08-08 Started working on voltage regulators
    [PWLinput.csv]
2020-08-09 Finished Voltage Regulator Analysis
2020-08-09 Started Voltage Regulator Measurements
2020-08-09 Started working on Temperature Sensor Amplifier Circuits
    [PWLinput.csv]
2020-08-10 Designed Second Order Filter
2020-08-10 Finished Design of combined Voltage Regulator, Low Pass Filter and Amplifier circuit.
2020-08-14 Cascaded the 2nd order filters to greatly reduce noise
    to greatly reduce noise
    [PWLinput.csv]
2020-08-14 Added unity gain buffer opamp
    [PWLinput.csv]
2020-08-14 Designed final circuit for submission
2020-08-14 Finished Assessment 1
    [PWLinput.csv]
2020-08-16 Filled in details
    [PWLinput.csv]
2020-08-18 Set the Initial Conditions for Assignment 2
    [PWLinput.csv]
2020-08-29 Took a first glance at Ass2
    [120.csv, 150.csv, 60.csv, 90.csv, BPM120.csv, BPM150.csv, BPM60.csv, BPM90.csv]
2020-09-17 Greatly simplified the circuit design
2020-09-21 Started writing the report
    [0_150.csv, 0_60.csv, 9_150.csv, 9_60.csv]
2020-09-23 Reported PWM
2020-09-29 comitted almost done!
    [0_150.csv, 50.csv, PWLinput.csv, PWLinputt.csv, minus10.csv, minus10.xlsx, plus10.csv]
2020-10-03 Started and finished Assignment 3
    [120.csv, 120_out.csv, 150.csv, 150_out.csv, 34.csv, 34_out.csv, 38.csv, 38_out.csv]
2020-10-23 started on ass3 part
    [HeartSensorPWL.csv, TempSensorPWL.csv, sig_in.csv]
2020-10-24 completed temperature sensor digitisation report
